joshieyu/DigitalAudioMixer/Documentation/Images/SSM2019TestOut.jpg

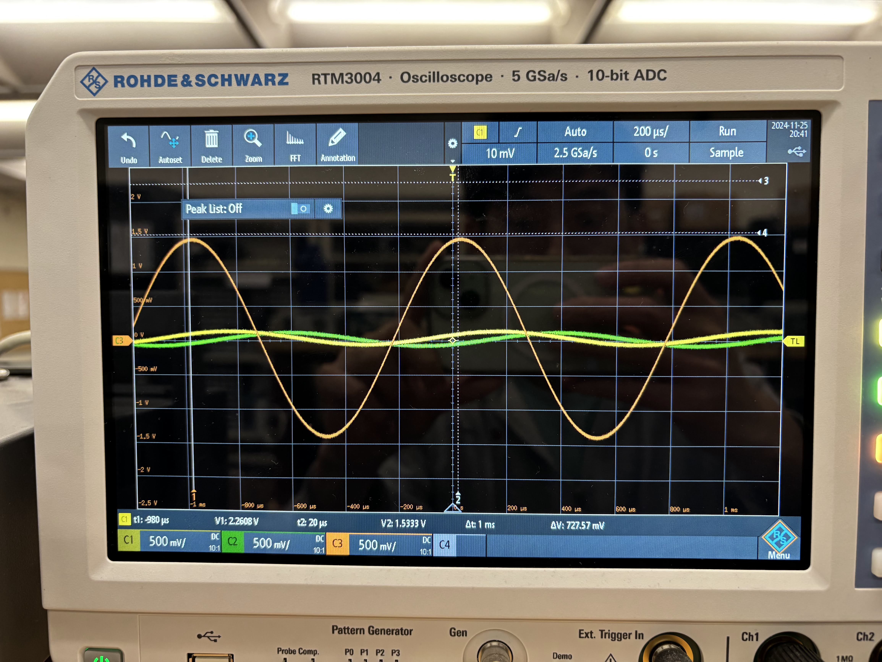
Documentation/Images/SSM2019TestOut.jpg
