joshieyu/DigitalAudioMixer/Documentation/Images/OPA2134TestOut.JPG

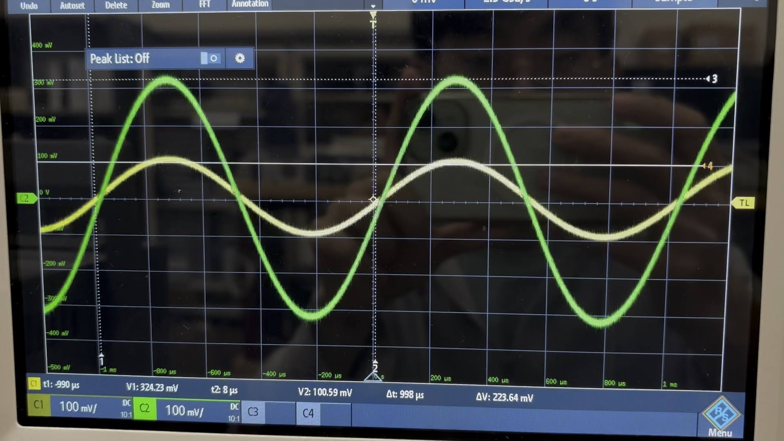
Documentation/Images/OPA2134TestOut.JPG
