joshieyu/DigitalAudioMixer/Resources/XK-AUDIO-316-MC-AB-Design-Files/XK-AUDIO-316-MC-AB-PCBA-1V1-A/README.txt

README.TXT
----------

Additional information relating to the build of PCB Assembly XK-AUDIO-316-MC-AB (xcore.ai MC audio board).

Design Ref    : XMS0004
Version       : 1V1
Build Variant : A

Date          : 17th August 2022

PCB Design tool : Altium Designer 21

Description of files included in XMS0004-PCBA-1V1-A.ZIP:

./README.TXT    This file.

./XK-AUDIO-316-MC-AB-ASSY-DWG-1V1-A.PDF    Assembly Drawing

./BOM/          This directory contains the bill of materials and component position files for assembly.

XK-AUDIO-316-MC-AB-XY-1V1-A.XLS    Component Position Data
XK-AUDIO-316-MC-AB-BOM-1V1-A.XLS   Bill Of Materials

./XK-AUDIO-316-MC-AB-PCB-1V1.zip       This is a zip file containing fabrication information for the PCB.
