joshieyu/DigitalAudioMixer/Documentation/Diagrams/biquad.jpg

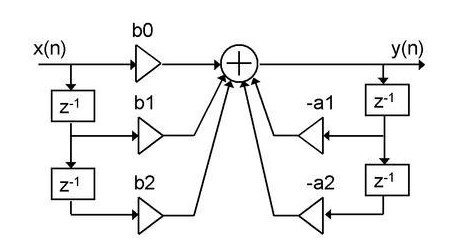
Documentation/Diagrams/biquad.jpg
