joshieyu/DigitalAudioMixer/Documentation/Diagrams/Hardware Flowchart (Chan Edition).png

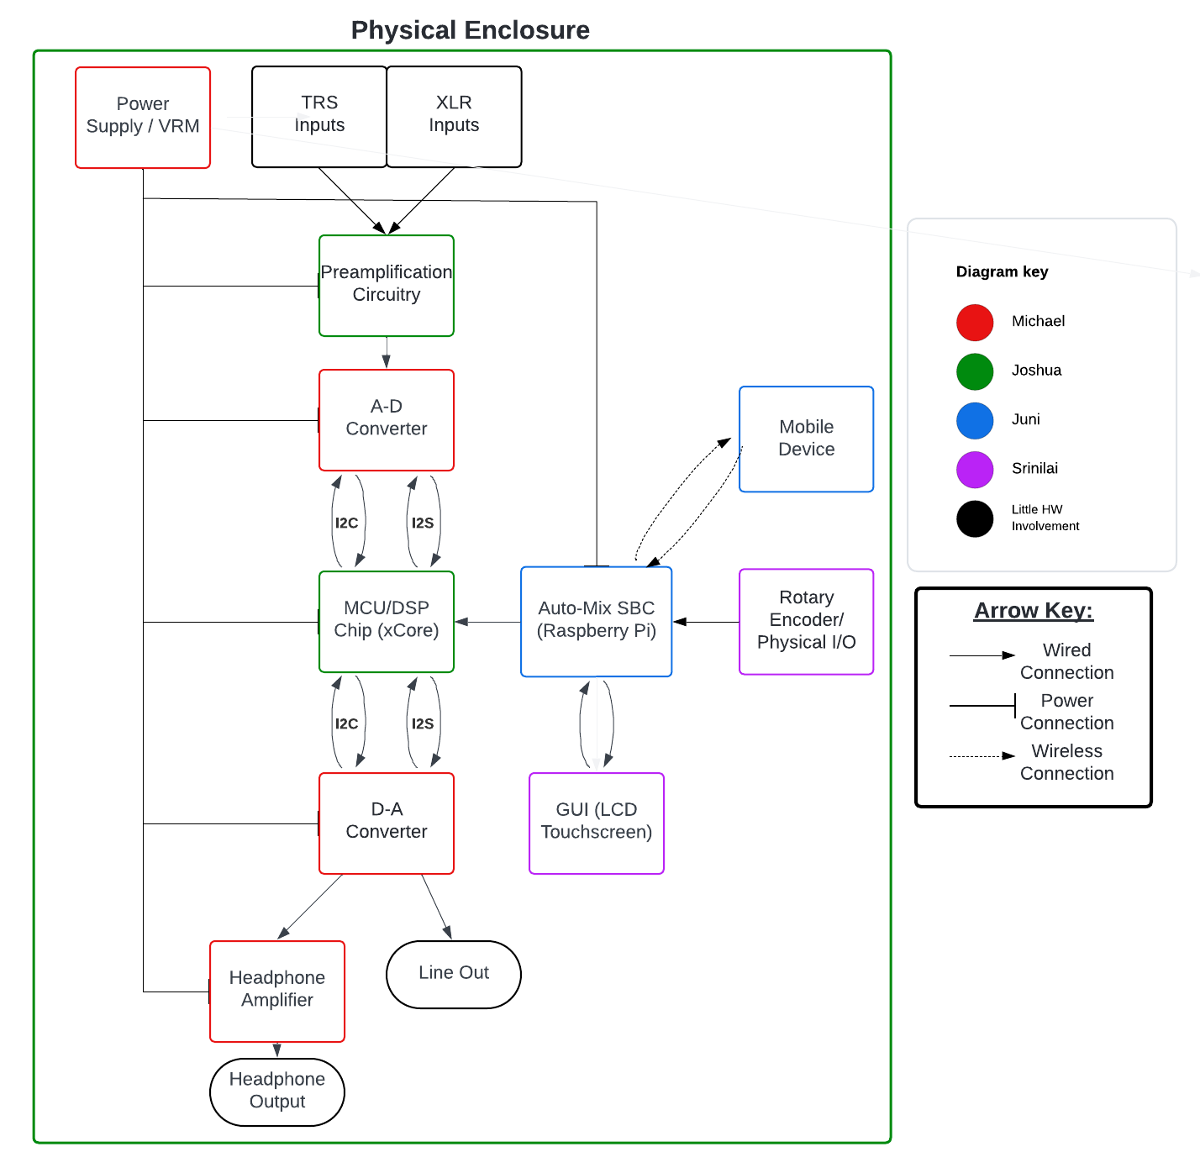
Documentation/Diagrams/Hardware Flowchart (Chan Edition).png
