joshieyu/DigitalAudioMixer/Documentation/imageRequests/biquadRequest.png

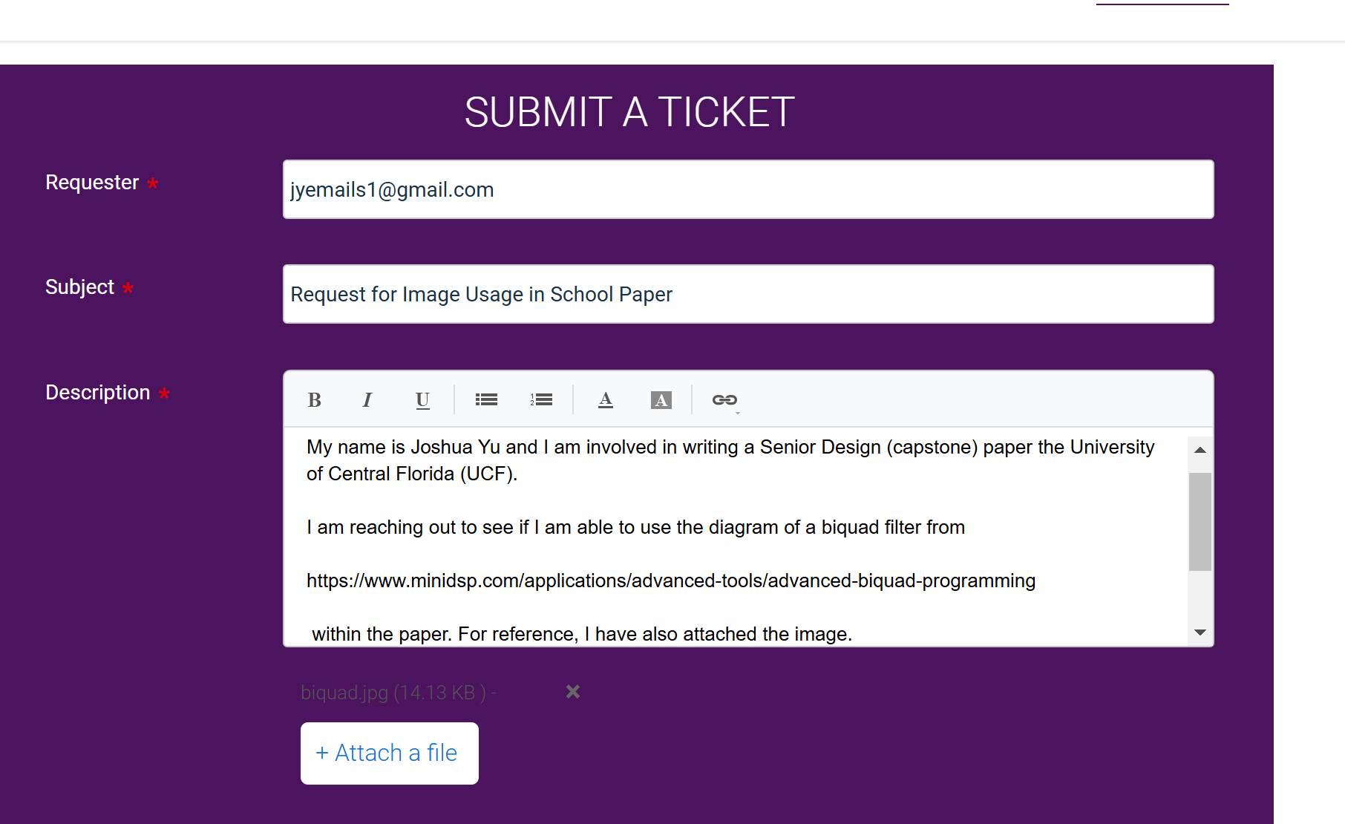
Documentation/imageRequests/biquadRequest.png
