joshieyu/DigitalAudioMixer/Documentation/imageRequests/biquadRequestApproval.png

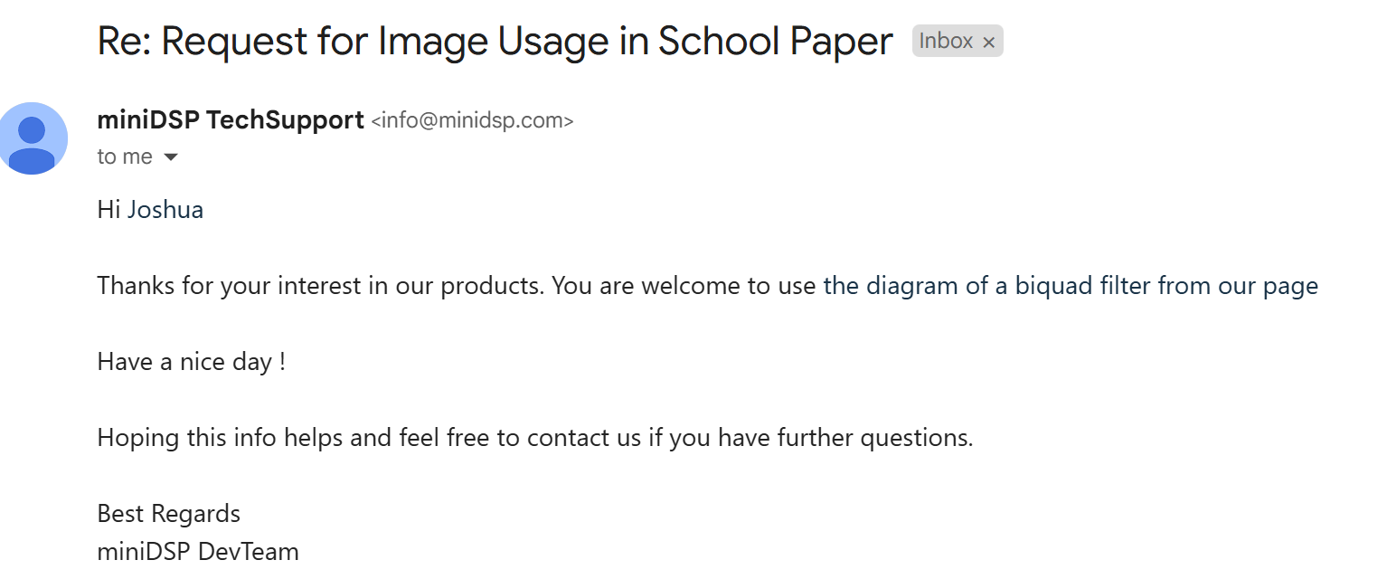
Documentation/imageRequests/biquadRequestApproval.png
