joshieyu/DigitalAudioMixer/Documentation/Images/BehringerFlow8.jpg

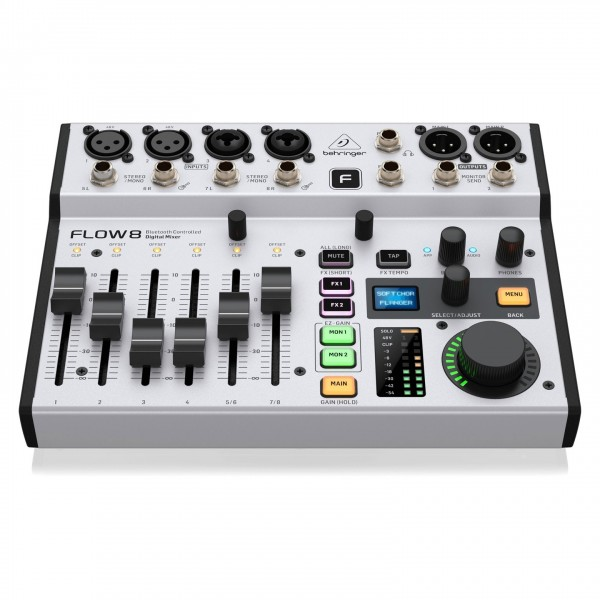
Documentation/Images/BehringerFlow8.jpg
