joshieyu/DigitalAudioMixer/Documentation/Images/MixerMockupCropped.png

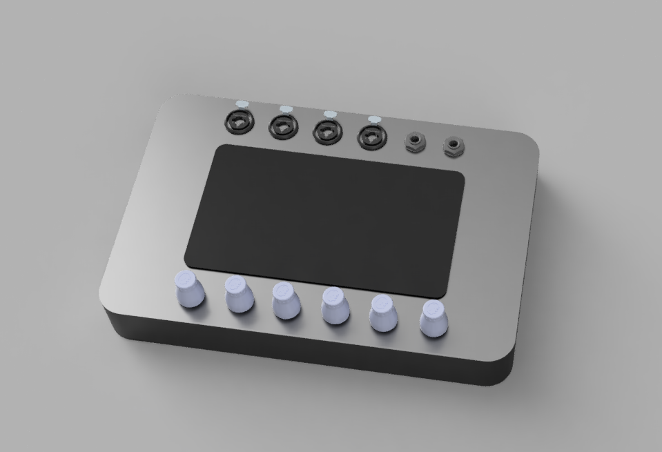
Documentation/Images/MixerMockupCropped.png
