joshieyu/DigitalAudioMixer/Documentation/Images/QSCTouchmix8.jpg

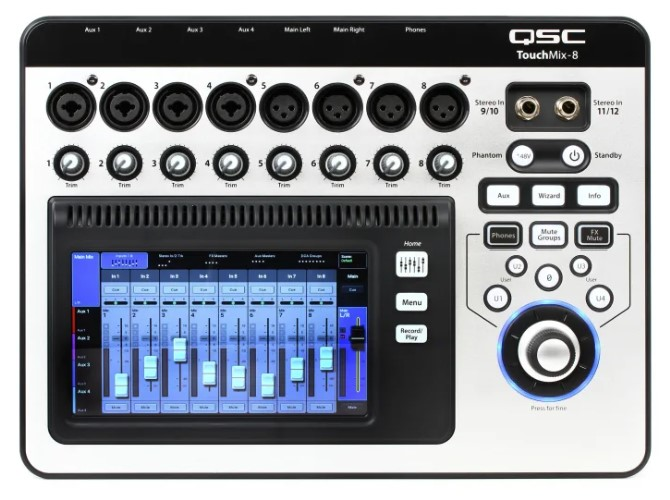
Documentation/Images/QSCTouchmix8.jpg
