joshieyu/DigitalAudioMixer/Documentation/Images/RaspberryPi5.jpg

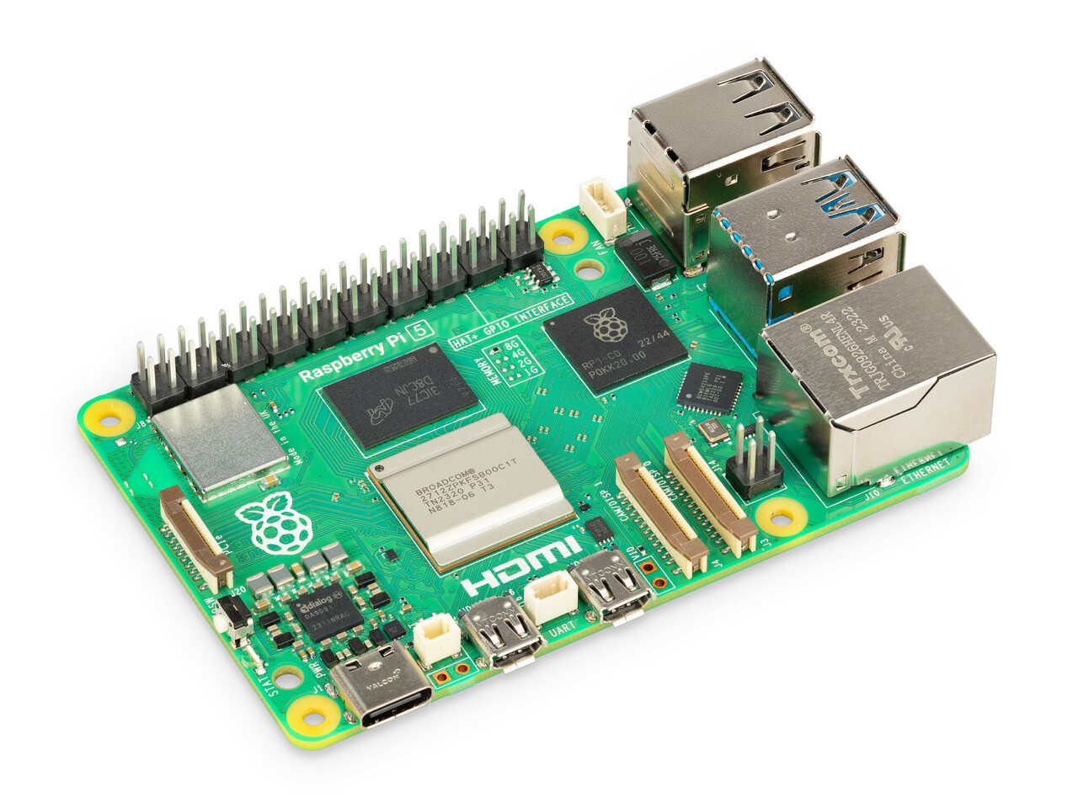
Documentation/Images/RaspberryPi5.jpg
