joshieyu/DigitalAudioMixer/Documentation/Images/SSM2019ChatGPT.png

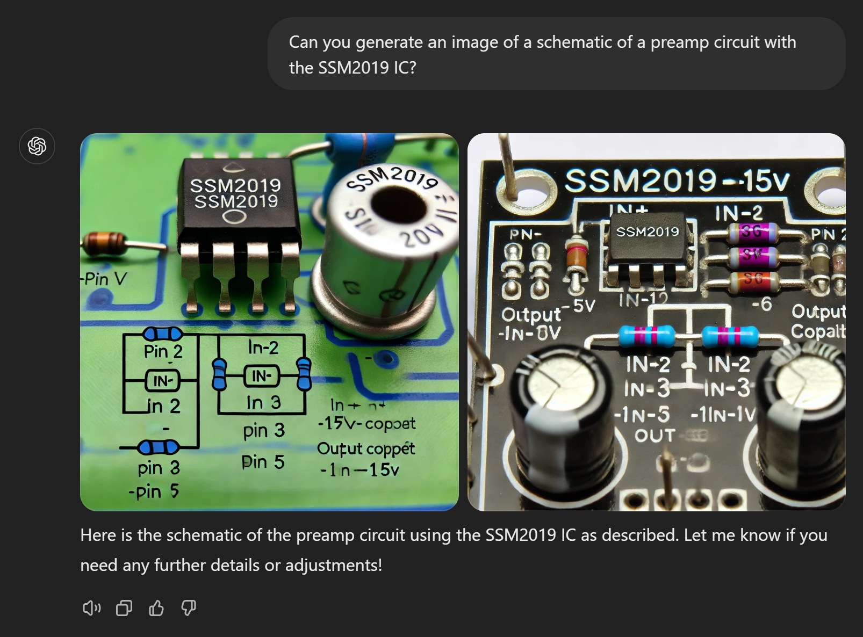
Documentation/Images/SSM2019ChatGPT.png
