joshieyu/DigitalAudioMixer/Documentation/Images/xcoreImage.jpg

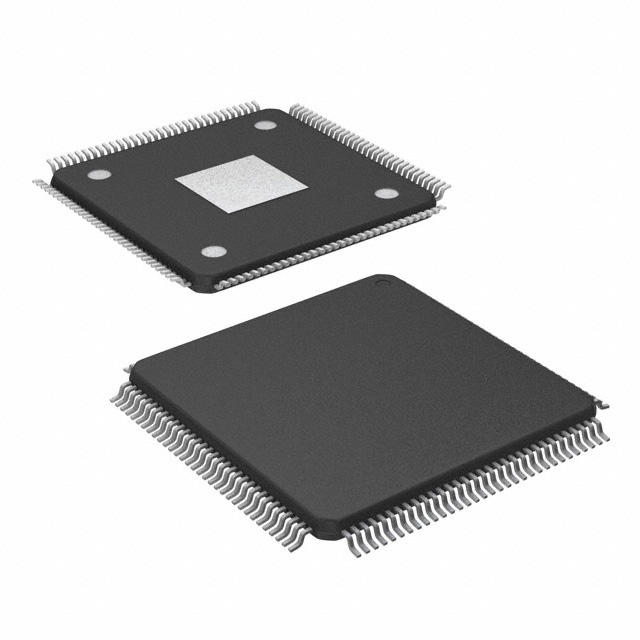
Documentation/Images/xcoreImage.jpg
