joshieyu/DigitalAudioMixer/Documentation/Schematics/InstPreampSchematic.png

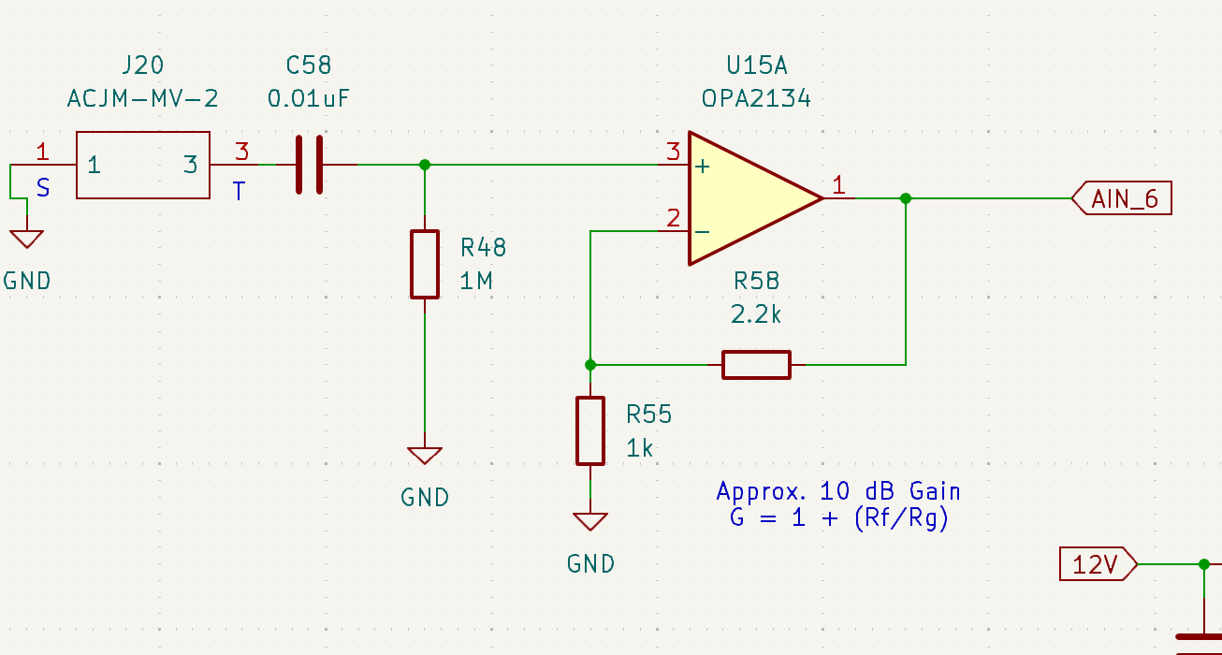
Documentation/Schematics/InstPreampSchematic.png
