joshieyu/DigitalAudioMixer/Documentation/Schematics/PreampSchematic.png

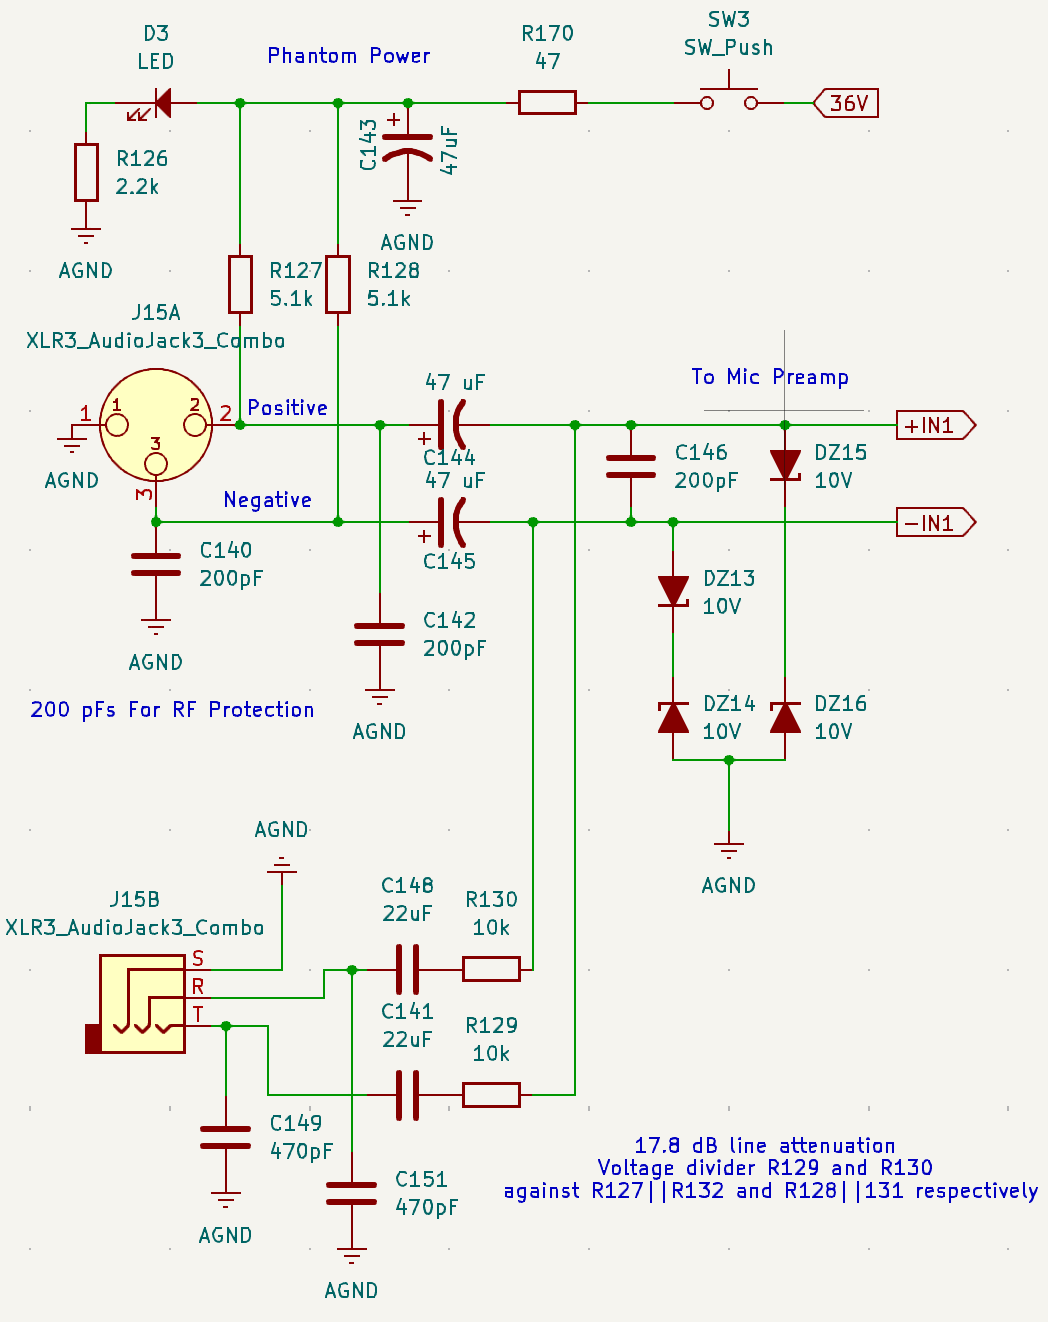
Documentation/Schematics/PreampSchematic.png
