joshieyu/DigitalAudioMixer/Documentation/Schematics/PreampSchematicFull.png

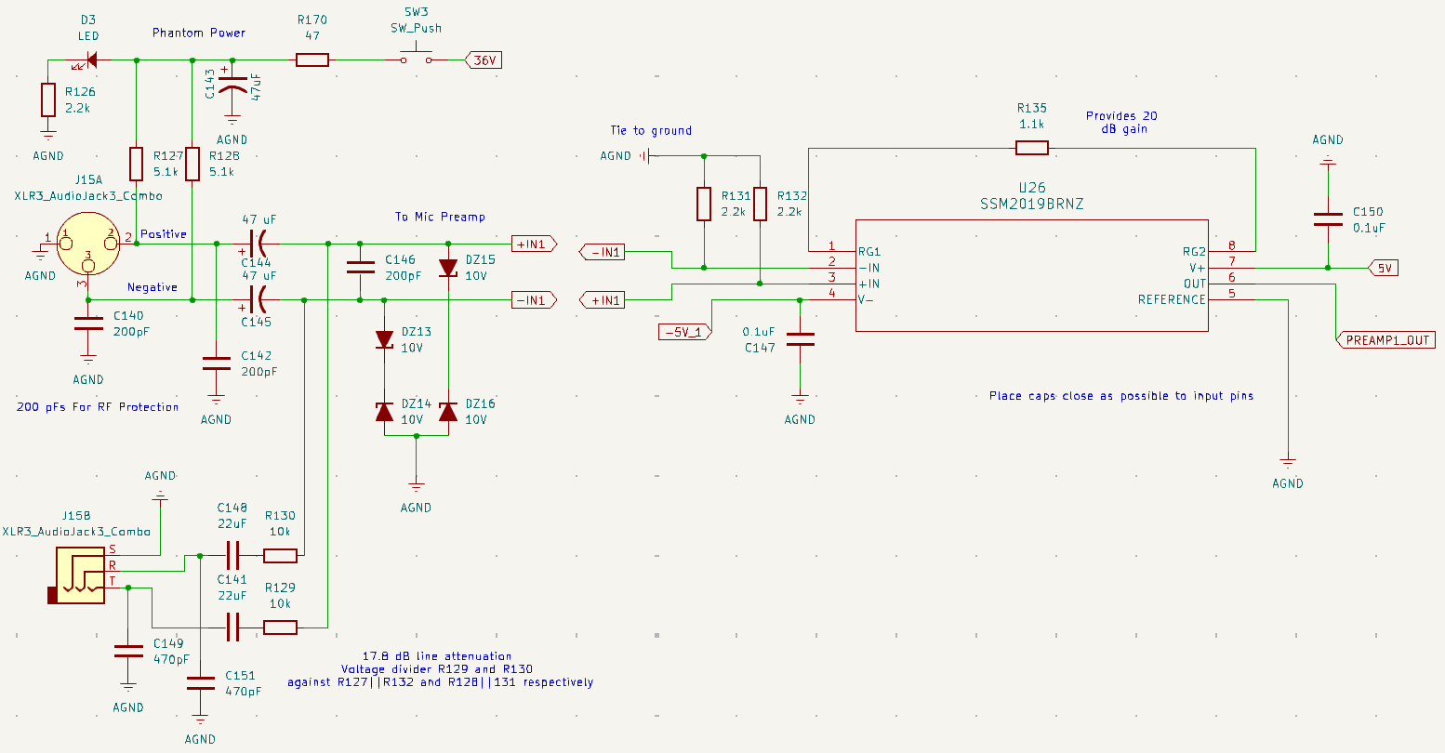
Documentation/Schematics/PreampSchematicFull.png
