joshieyu/DigitalAudioMixer/website/src/assets/crewmates/blue.png

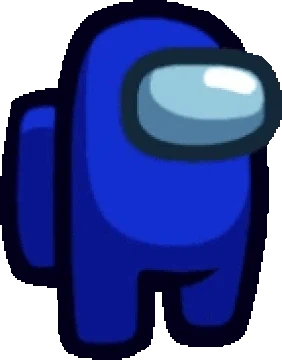
website/src/assets/crewmates/blue.png
