joshieyu/DigitalAudioMixer/website/src/assets/crewmates/yellow.png

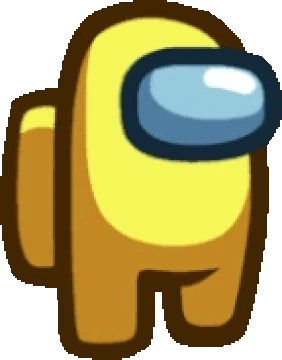
website/src/assets/crewmates/yellow.png
