joshieyu/DigitalAudioMixer/website/src/assets/roleReveal.png

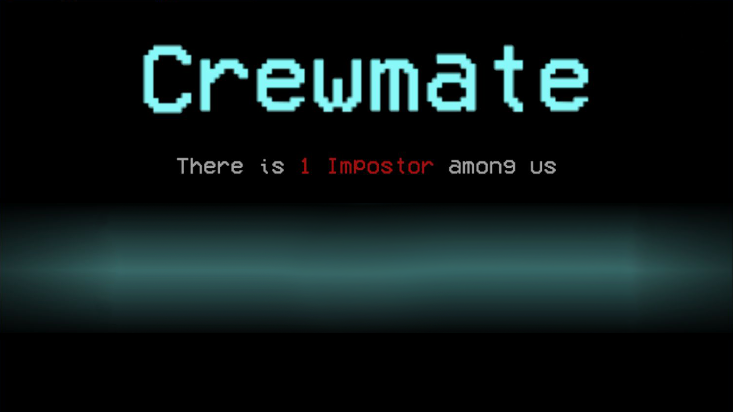
website/src/assets/roleReveal.png
