joshieyu/DigitalAudioMixer/Resources/XK-AUDIO-316-MC-AB-Design-Files/XK-AUDIO-316-MC-AB-PCBA-1V1-A/BOM/XK-AUDIO-316-MC-AB-BOM-1V1-A.xls

BILL OF MATERIALS
DESIGN | XMS0004
REVISION | 1V1
VARIANT | A
DATE | 17/08/2022 17:56:27
ITEM | DESCRIPTION | MANUFACTURER | PART NUMBER | QUANTITY | DESIGNATOR
1 | Pin Header, Male, Vertical, Through Hole, 2 Way, 1x2, 0.1 Inch Pitch | FCI | 68001-202HLF | 5 | J14, J17, J30, J39, J40
2 | USB Micro B Receptacle, Right Angle, SMD w/2 DIP Legs | FCI | 10118193-0001LF | 3 | J2, J16, J23
3 | TRS jack, 3.5mm, SMD | CUI | SJ-3523-SMT | 8 | J18, J19, J20, J21, J25, J26, J27, J28
4 | Pin Header, Male, Vertical, Through Hole, 3 Way, 1x3, 0.1 Inch Pitch | FCI | 68001-203HLF | 1 | J22
5 | Pin Header, Male, Vertical, Through Hole, 20 Way, 2x10, 0.1 Inch Pitch | FCI | 67997-220HLF | 1 | J7
6 | Optical Digital Audio Transmitter, Black Shutter, 16Mbps max, 2.7-5.5V, Through Hole | Aixin Opto-Electrical Technology | DLT1160A-B | 1 | J35
7 | Optical Digital Audio Receiver, Black Shutter, 16Mbps max, 2.7-5.5V, Through Hole | Aixin Opto-Electrical Technology | DLR1160-B | 1 | J36
8 | Standard DIN Connector, 5 Pin, 180 degrees, PCB Mount, Right Angle, Through Hole | CUI | SDS-50J | 2 | J31, J32
9 | RCA Jack, Right Angle, Orange, Through Hole | CUI | RCJ-017 | 2 | J33, J34
10 | Pin Header, Male, Vertical, Through Hole, 4 Way, 1x4, 0.1 Inch Pitch | FCI | 68001-204HLF | 8 | J3, J6, J8, J9, J10, J11, J12, J13
11 | BNC Jack, Board Mount, Vertical, 75 ohm, w/Mounting Posts | TE Connectivity | 5-1634503-3 | 1 | J29
12 | CHIP RESISTOR, 0.5 OHM, 100mW, 1%, 0603 | Yageo | RL0603FR-070R5L | 1 | R62
13 | CHIP RESISTOR, 0.1 OHM, 100mW, 1%, 0603 | Yageo | RL0603FR-070R1L | 1 | R73
14 | CHIP RESISTOR ARRAY, 4 ELEMENT, 36 OHM, 63mW, 5%, 0804 | Panasonic | EXB-28V360JX | 2 | R3, R14
15 | CHIP RESISTOR, 0.1 OHM, 250mW, 1%, 0805 | Yageo | RL0805FR-7W0R1L | 1 | R47
16 | CHIP CAPACITOR, CERAMIC, 2.2UF, 6.3V, 10%, X5R, 0402 | AVX | 04026D225KAT2A | 1 | C9
17 | CHIP CAPACITOR, CERAMIC, 10UF, 10V, 20%, X5R, 0603 | Murata | GRM188R61A106ME69 | 5 | C36, C38, C107, C111, C113
18 | CHIP CAPACITOR, CERAMIC, 22UF, 6.3V, 20%, X5R, 0603 | Murata | GRM188R60J226MEA0 | 1 | C117
19 | CHIP CAPACITOR, CERAMIC, 10UF, 10V, 20%, X7R, 0805 | Murata | GRM21BR71A106MA73L | 8 | C120, C121, C126, C127, C130, C131, C136, C137
20 | Ferrite Bead, 220R AT 100MHz, For Power Lines, AEC-Q200, 0603, 2.2A | Murata | BLM18KG221BH1 | 3 | FB1, FB5, FB6
21 | Ferrite Bead, 1000R AT 100MHz, For Signal Lines, 0402, 0.25A | Murata | BLM15HD102SN1 | 6 | FB2, FB3, FB7, FB8, FB9, FB10
22 | Power Inductor, 1.5uH, 2.6A, 65mR DCR, 2.5x2.0x1.2mm, SMD | Taiyo Yuden | MAMK2520H1R5M | 3 | L1, L2, L3
23 | Stereo Audio DAC, 32 bit/384kHz, 112dB SNR, PLL, 2Vrms Output, TSSOP28 | Texas Instruments | PCM5122PW | 4 | U10, U11, U12, U13
24 | Audio ADC, 4-Channel, 24 bit/192kHz, Single Ended or Differential, 110dB SNR, I2C/SPI Control, TSSOP30 | Texas Instruments | PCM1865DBTR | 2 | U19, U20
25 | Clock Generator, I2C Programmable, XTAL Input, 3 Outputs, MSOP10 | Silicon Labs | SI5351A-B-GT | 1 | U26
26 | Fractional-N Clock Multiplier, I2C/SPI Control, MSOP10 | Cirrus Logic | CS2100CP-CZZ | 1 | U22
27 | Processor, xcore.ai, 2400MIPS, 1.8V VDDIO, 60QFN | XMOS | XU316-1024-QF60A-C24 | 1 | U3
28 | Processor, xcore.ai, 2400MIPS, 128TQFP | XMOS | XU316-1024-TQ128-C24 | 1 | U8
29 | 2-channel I2C-bus multiplexer, TSSOP8 | NXP | PCA9540BDP,118 | 1 | U33
30 | Configurable Dual-Voltage Supply Translator, 4 bit, DQFN16 | Fairchild | FXL4TD245BQX | 2 | U2, U4
31 | Triple Logic Buffer, UHS Series, US8 | Fairchild | NC7NZ34K8X | 1 | U23
32 | Single Unbuffered Inverter, LVC Series, SOT23-5 | Nexperia | 74LVC1GU04GV | 1 | U30
33 | Single Buffer with 3-State Output, LVC Series, SON6 | Texas Instruments | SN74LVC1G125DRYR | 4 | U5, U21, U27, U32
34 | Two Input Non-Inverting Multiplexer, LVC Series, TSOP6 | Nexperia | 74LVC1G157GV | 2 | U24, U25
35 | Single D-Type Flip Flop with Reset, Positive Edge Trigger, LVC Series, SOT23-6 (SC-74) | Nexperia | 74LVC1G175GV | 2 | U29, U31
36 | Memory, Flash, SPI, Multi-IO, 8Mb (4Kx256), 1.65V to 1.95V, USON-8 (2x3mm) | Winbond | W25Q80EWUXIE | 1 | U1
37 | Memory, Flash, SPI, Multi-IO, 32Mb (16Kx256), 2.7 to 3.6V, QE = 1, SOIC-8-W | Winbond | W25Q32JVSSIQ | 1 | U9
38 | Optocoupler, Schmitt Trigger Output, 3-15V, 1.6mA Turn-On, PDIP6_SMD | ON Semiconductor | H11L1SM | 1 | U28
39 | Voltage Regulator, Dual, 3.3V/1.8V, 150mA, Low Iq, Low Dropout, X2SON-6 | Texas Instruments | TLV7163318PDPQR | 1 | U6
40 | DC-DC Synchronous Buck Converter, Adjustable, PFM/PWM, Power Good, 2.2MHz, 1A, SOT563 | Diodes Incorporated | AP61102Z6-7 | 3 | U7, U16, U17
41 | Voltage Regulator, Linear, Fixed, 1V8, 200mA, Low Iq=2uA, Output Active Discharge, TSOT23-5 | Toshiba | TCR2LF18,LM | 1 | U18
42 | USB Positive Overvoltage Protection Controller, Internal P-FET, OVLO 6.25V, TSOT23-5 | ON Semiconductor | NCP360SNAET1G | 1 | U14
43 | Voltage Regulator, Linear, Fixed, 3V3, 700mA, w/enable, SOT89-5 | Torex Semiconductor | XC6227C331PR-G | 1 | U15
44 | Precision Adjustable Current Limited Load Switch, 3.0 - 5.5V, 2.1A max, Active High Enable, SOT26 | Diodes Incorporated | AP22653W6-7 | 2 | U34, U35
45 | Crystal, 24MHz, Freq Tol. ±30ppm, Freq Stab. ±30ppm, CL 12pF, 3.2x2.5mm SMD | Seiko Epson | FA-238 24.0000MD30X-W | 1 | X2
46 | Crystal, 24MHz, Freq Tol. ±8ppm, Freq Stab. ±12ppm, CL 10pF, Max ESR 70 Ohm, 2.0x1.6mm SMD | Murata | XRCGB24M000FFS1CR0 | 1 | X1
47 | Crystal, 25MHz, Freq Tol. ±25ppm, Freq Stab. ±40ppm, CL 8pF, Max ESR 80 Ohm, 2.0x1.6mm SMD | Murata | XRCGB25M000FAM10R0 | 1 | X4
48 | Crystal, 24MHz, Freq Tol. ±30ppm, Freq Stab. ±30ppm, CL 18pF, Max ESR 40 Ohm, 5x3.2mm SMD | CTS | 445C33D24M00000 | 1 | X3
49 | Polymer ESD Protection Device, 24V Stand-Off, 0.25pF, 0603 | Tyco | PESD0603-240 | 2 | D11, D12
50 | ESD Protection Diode Array, 0.6pF, SC-70-6 (SC-88) | ON Semiconductor | NUP4114UCLW1T2G | 2 | D2, D8
51 | BJT Transistor, NPN, 40V, 200mA, SOT23 | Nexperia | MMBT3904,215 | 1 | Q1
52 | Zener Diode, 3.9V, 2%, 0.2W, SOD-323F | ON Semiconductor | MM3Z3V9B | 1 | D13
53 | Diode, 100V, 0.2A, SOD123 | ON Semiconductor | MMSD914T1G | 2 | D9, D10
54 | LED, GREEN, 0603 | Kingbright | APT1608CGCK | 4 | D4, D5, D6, D7
55 | LED, Top View, RED/GREEN, SMD, 0606 | Lite-On | LTST-C195KGJRKT | 2 | D1, D3
56 | Tactile Switch, Momentary, J Bend SMD | C&K | KSC421J 70SH LFS | 3 | SW1, SW2, SW3
57 | PTC Fuse, SMD, 0.35A hold, 0.75A trip, 6V, 0805 | Bel Fuse | 0ZCK0035FF2G | 1 | F1
58 | Snap-in PCB Spacer Support, 6mm | KANG YANG (Toby Electronics) | DCB-6 | 8 | PROD12, PROD13, PROD14, PROD15, PROD16, PROD17, PROD18, PROD19
59 | Jumper Shunt, Single Circuit, Open Type, 2.54mm Pitch, 6mm High, Gold Flash | Sullins | QPC02SXGN-RC | 12 | PROD1, PROD2, PROD3, PROD4, PROD5, PROD6, PROD7, PROD8, PROD9, PROD10, PROD11, PROD24
60 | Machine screw, M2 thread, 6mm length, Steel, BZP, Pan head Pozidriv | TR Fastenings | M2 6 PRSTMC Z100 | 4 | PROD20, PROD21, PROD22, PROD23
61 | CHIP RESISTOR, 680 OHM, 63mW, 1%, 0402 | Yageo | RC0402FR-07680RL | 1 | R21
62 | CHIP RESISTOR, 4.7K OHM, 63mW, 1%, 0402 | Yageo | RC0402FR-074K7L | 6 | R2, R7, R8, R9, R10, R22
63 | CHIP RESISTOR, 10K OHM, 63mW, 1%, 0402 | Yageo | RC0402FR-0710KL | 6 | R4, R5, R11, R16, R17, R29
64 | CHIP RESISTOR, 20K OHM, 63mW, 1%, 0402 | Yageo | RC0402FR-0720KL | 1 | R30
65 | CHIP RESISTOR, 47K OHM, 63mW, 1%, 0402 | Yageo | RC0402FR-0747KL | 1 | R28
66 | CHIP RESISTOR, 150K OHM, 63mW, 1%, 0402 | Yageo | RC0402FR-07150KL | 1 | R31
67 | CHIP RESISTOR, 1.0M OHM, 63mW, 5%, 0402 | Yageo | RC0402JR-071ML | 1 | R19
68 | CHIP RESISTOR, ZERO OHM JUMPER, 1A, 0603 | Yageo | RC0603JR-070RL | 14 | R53, R54, R60, R61, R68, R83, R89, R105, R116, R118, R120, R123, R139, R140
69 | CHIP RESISTOR, 33 OHM, 0.1W, 1%, 0603 | Yageo | RC0603FR-0733RL | 23 | R12, R13, R24, R25, R27, R32, R39, R40, R80, R86, R90, R93, R94, R95, R96, R97, R98, R99, R115, R117, R122, R125, R126
70 | CHIP RESISTOR, 68 OHM, 0.1W, 1%, 0603 | Yageo | RC0603FR-0768RL | 1 | R108
71 | CHIP RESISTOR, 100 OHM, 0.1W, 1%, 0603 | Yageo | RC0603FR-07100RL | 1 | R111
72 | CHIP RESISTOR, 220 OHM, 0.1W, 1%, 0603 | Yageo | RC0603FR-07220RL | 4 | R109, R110, R113, R114
73 | CHIP RESISTOR, 470 OHM, 0.1W, 1%, 0603 | Yageo | RC0603FR-07470RL | 13 | R33, R34, R35, R36, R49, R50, R51, R52, R55, R56, R57, R58, R102
74 | CHIP RESISTOR, 680 OHM, 0.1W, 1%, 0603 | Yageo | RC0603FR-07680RL | 1 | R20
75 | CHIP RESISTOR, 1.0K OHM, 0.1W, 1%, 0603 | Yageo | RC0603FR-071KL | 1 | R91
76 | CHIP RESISTOR, 4.7K OHM, 0.1W, 1%, 0603 | Yageo | RC0603FR-074K7L | 7 | R41, R42, R63, R127, R128, R129, R130
77 | CHIP RESISTOR, 10K OHM, 0.1W, 1%, 0603 | Yageo | RC0603FR-0710KL | 16 | R15, R23, R37, R38, R43, R59, R69, R72, R74, R106, R119, R121, R135, R136, R138, R142
78 | CHIP RESISTOR, 15K OHM, 0.1W, 1%, 0603 | Yageo | RC0603FR-0715KL | 1 | R70
79 | CHIP RESISTOR, 20K OHM, 0.1W, 1%, 0603 | Yageo | RC0603FR-0720KL | 2 | R66, R76
80 | CHIP RESISTOR, 47K OHM, 0.1W, 1%, 0603 | Yageo | RC0603FR-0747KL | 9 | R44, R78, R79, R81, R82, R84, R85, R87, R88
81 | CHIP RESISTOR, 68K OHM, 0.1W, 1%, 0603 | Yageo | RC0603FR-0768KL | 3 | R67, R71, R143
82 | CHIP RESISTOR, 100K OHM, 0.1W, 1%, 0603 | Yageo | RC0603FR-07100KL | 4 | R45, R46, R64, R107
83 | CHIP RESISTOR, 220K OHM, 0.1W, 1%, 0603 | Yageo | RC0603FR-07220KL | 1 | R77
84 | CHIP RESISTOR, 240K OHM, 0.1W, 1%, 0603 | Yageo | RC0603FR-07240KL | 1 | R75
85 | CHIP RESISTOR, 470K OHM, 0.1W, 1%, 0603 | Yageo | RC0603FR-07470KL | 1 | R48
86 | CHIP RESISTOR, 1.0M OHM, 0.1W, 5%, 0603 | Yageo | RC0603JR-071ML | 1 | R18
87 | CHIP RESISTOR, 10 OHM, 0.25W, 1%, 1206 | Yageo | RC1206FR-0710RL | 1 | R104
88 | CHIP RESISTOR, 68 OHM, 0.25W, 1%, 1206 | Yageo | RC1206FR-0768RL | 2 | R100, R101
89 | CHIP RESISTOR, 75 OHM, 0.25W, 1%, 1206 | Yageo | RC1206FR-0775RL | 2 | R92, R112
90 | CHIP RESISTOR, 220 OHM, 0.25W, 1%, 1206 | Yageo | RC1206FR-07220RL | 1 | R103
91 | CHIP CAPACITOR, CERAMIC, 18PF, 50V, 5%, NP0, 0402 | Yageo | CC0402JRNPO9BN180 | 4 | C11, C12, C60, C61
92 | CHIP CAPACITOR, CERAMIC, 27PF, 50V, 5%, NP0, 0402 | Yageo | CC0402JRNPO9BN270 | 2 | C144, C145
93 | CHIP CAPACITOR, CERAMIC, 33PF, 50V, 5%, NP0, 0402 | Yageo | CC0402JRNPO9BN330 | 1 | C156
94 | CHIP CAPACITOR, CERAMIC, 100PF, 50V, 10%, X7R, 0402 | Yageo | CC0402KRX7R9BB101 | 1 | C110
95 | CHIP CAPACITOR, CERAMIC, 470PF, 50V, 10%, X7R, 0402 | Yageo | CC0402KRX7R9BB471 | 1 | C37
96 | CHIP CAPACITOR, CERAMIC, 10NF, 50V, 10%, X7R, 0402 | Yageo | CC0402KRX7R9BB103 | 5 | C63, C108, C155, C174, C177
97 | CHIP CAPACITOR, CERAMIC, 100NF, 16V, 10%, X7R, 0402 | Yageo | CC0402KRX7R7BB104 | 103 | C1, C2, C3, C4, C7, C8, C10, C16, C17, C18, C19, C20, C21, C22, C23, C24, C25, C26, C27, C28, C29, C30, C31, C32, C33, C34, C35, C39, C40, C41, C42, C43, C44, C45, C46, C47, C48, C49, C50, C51, C52, C53, C54, C55, C56, C57, C58, C59, C62, C64, C72, C73, C75, C76, C78, C79, C81, C82, C90, C91, C93, C94, C96, C97, C99, C100, C103, C104, C106, C114, C123, C125, C133, C135, C140, C141, C142, C143, C146, C147, C148, C149, C151, C153, C154, C157, C158, C159, C160, C161, C162, C163, C164, C165, C166, C167, C168, C169, C170, C171, C172, C173, C175
98 | CHIP CAPACITOR, CERAMIC, 2.2NF, 50V, 5%, NP0, 0603 | Murata | GRM1885C1H222JA01D | 8 | C65, C66, C67, C68, C83, C84, C85, C86
99 | CHIP CAPACITOR, CERAMIC, 100NF, 50V, 10%, X7R, 0603 | Yageo | CC0603KRX7R9BB104 | 2 | C150, C152
100 | CHIP CAPACITOR, CERAMIC, 1.0UF, 16V, 10%, X5R, 0402 | Murata | GRM155R61C105MA12D | 11 | C5, C6, C13, C14, C15, C101, C102, C112, C118, C119, C176
101 | CHIP CAPACITOR, CERAMIC, 560PF, 50V, 5%, NP0, 0402 | Yageo | CC0402JRNPO9BN561 | 1 | C116
102 | CHIP CAPACITOR, CERAMIC, 4.7UF, 16V, 10%, X5R, 0603 | Murata | GRM188R61C475KE11D | 12 | C74, C80, C92, C98, C105, C109, C115, C122, C124, C132, C134, C178
103 | CHIP CAPACITOR, CERAMIC, 2.2UF, 16V, 10%, X5R, 0603 | Yageo | CC0603KRX5R7BB225 | 12 | C69, C70, C71, C77, C87, C88, C89, C95, C128, C129, C138, C139
104 | CHIP RESISTOR ARRAY, 4 ELEMENT, 470 OHM, 63mW, 5%, 0804 | Yageo | YC124-JR-07470RL | 1 | R1
105 | CHIP RESISTOR ARRAY, 4 ELEMENT, 47K OHM, 63mW, 5%, 0804 | Yageo | YC124-JR-0747KL | 1 | R6
NA | NO FIT COMPONENTS | NA | NA | 0 | J15, J24, J38, J1, J37, J41, J42, J43, J44, J4, J45, FB4, F2, R26, R65, R124, R131, R132, R133, R134, R141, R137
