joshieyu/DigitalAudioMixer/CAD/Parts/jack-1-4-1.snapshot.3/Jack1_4/Jack1_4.jpg

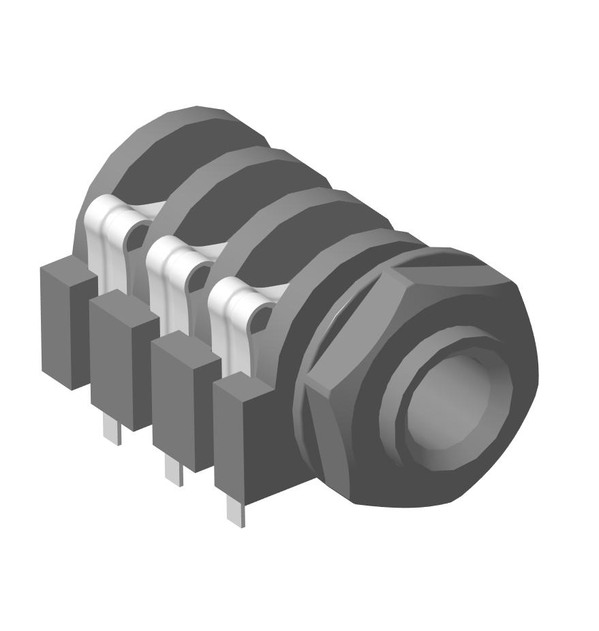
CAD/Parts/jack-1-4-1.snapshot.3/Jack1_4/Jack1_4.jpg
