joshieyu/DigitalAudioMixer/CAD/Parts/ky-040-knob-1.snapshot.2/ky040 knob.47.jpg

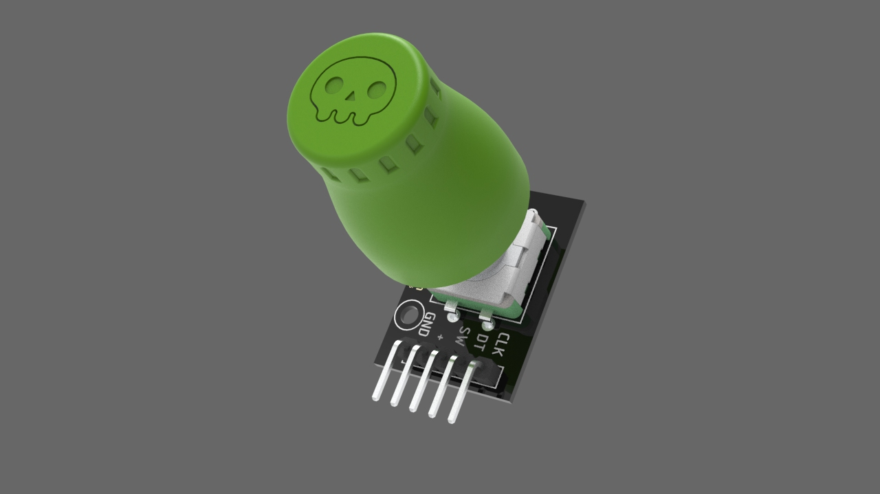
CAD/Parts/ky-040-knob-1.snapshot.2/ky040 knob.47.jpg
