joshieyu/DigitalAudioMixer/CAD/Parts/schurter-4304-6071-1.snapshot.6/Schurter - 4304.6071 Top.jpg

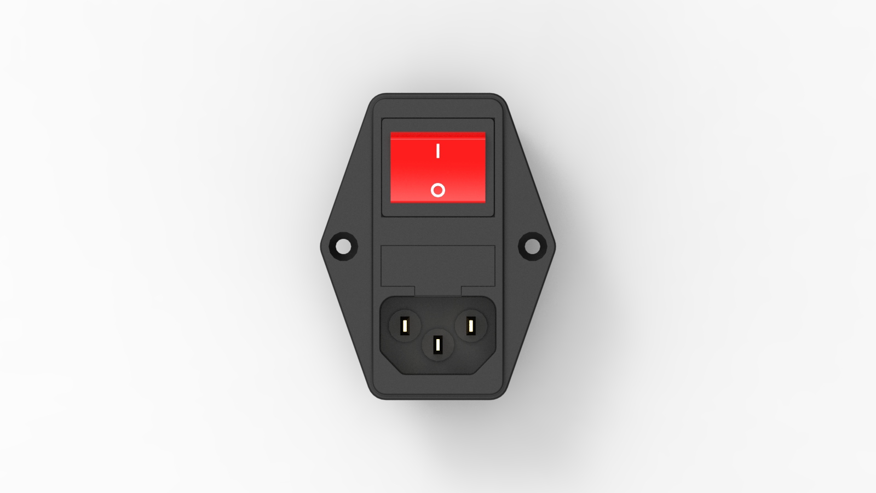
CAD/Parts/schurter-4304-6071-1.snapshot.6/Schurter - 4304.6071 Top.jpg
