joshieyu/DigitalAudioMixer/CAD/Parts/trs-jack-pj-313-1.snapshot.1/TRS Jack PJ-313(1).JPG

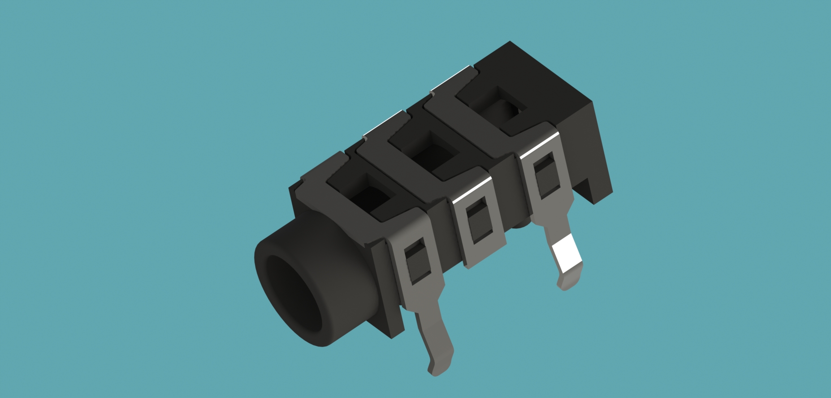
CAD/Parts/trs-jack-pj-313-1.snapshot.1/TRS Jack PJ-313(1).JPG
