joshieyu/DigitalAudioMixer/CAD/Parts/trs-jack-pj-313-1.snapshot.1/TRS Jack PJ-313/TRS Jack PJ-313.SLDASM

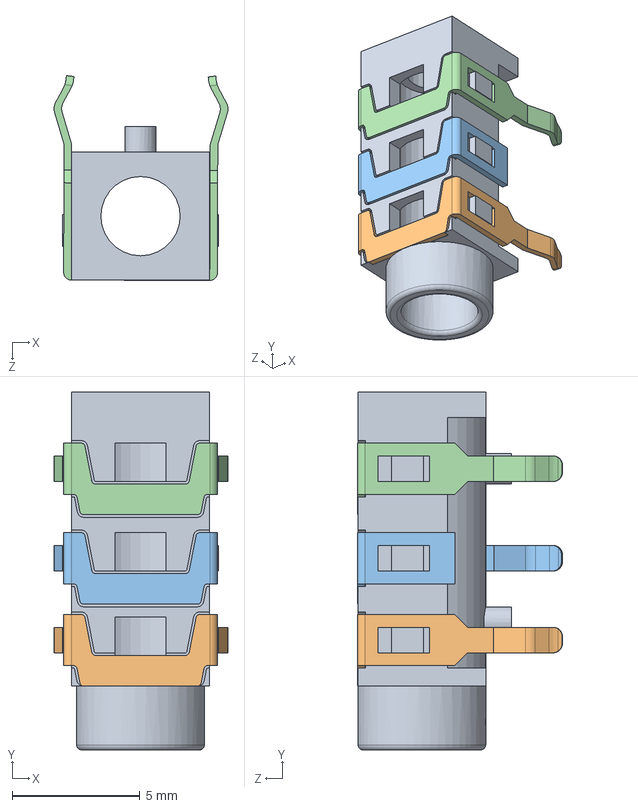
[picture p41: CAD file, 2024-07-25]
CAD/Parts/trs-jack-pj-313-1.snapshot.1/TRS Jack PJ-313/TRS Jack PJ-313.SLDASM
6.80 x 14.0 x 8.02 mm
