joshieyu/DigitalAudioMixer/CAD/Parts/rotary-encoder-1.snapshot.8/rotary encoder step files/Step Files/Rotary Encoder without pcb Assembly.stp

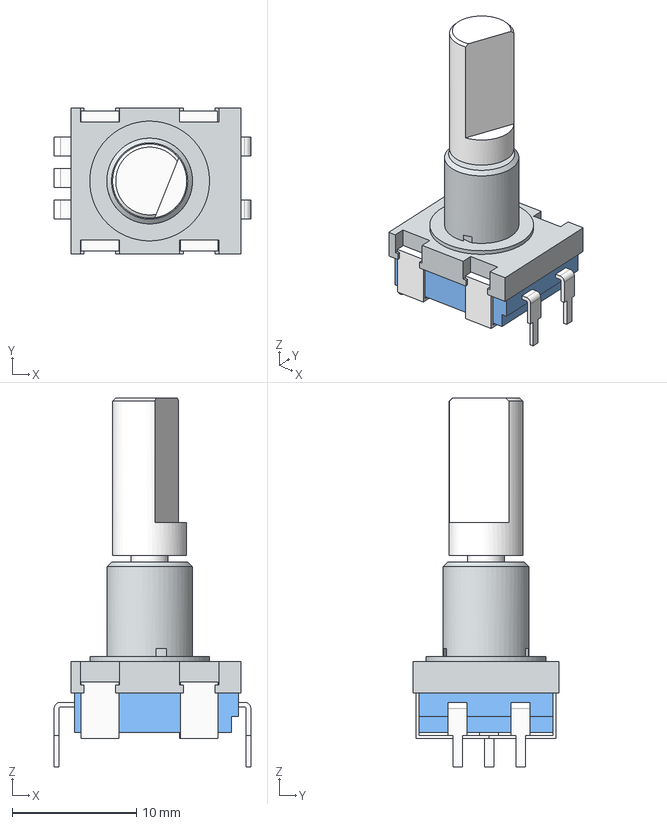
[picture p42: CAD file, 2024-07-25]
CAD/Parts/rotary-encoder-1.snapshot.8/rotary encoder step files/Step Files/Rotary Encoder without pcb Assembly.stp
15.8 x 11.8 x 29.7 mm
mtg flange
body_encoder
pins_encoder body_2 x 5
shaft_encoder
