joshieyu/DigitalAudioMixer/CAD/Parts/jack-1-4-1.snapshot.3/Jack1_4/Jack1_4.stp

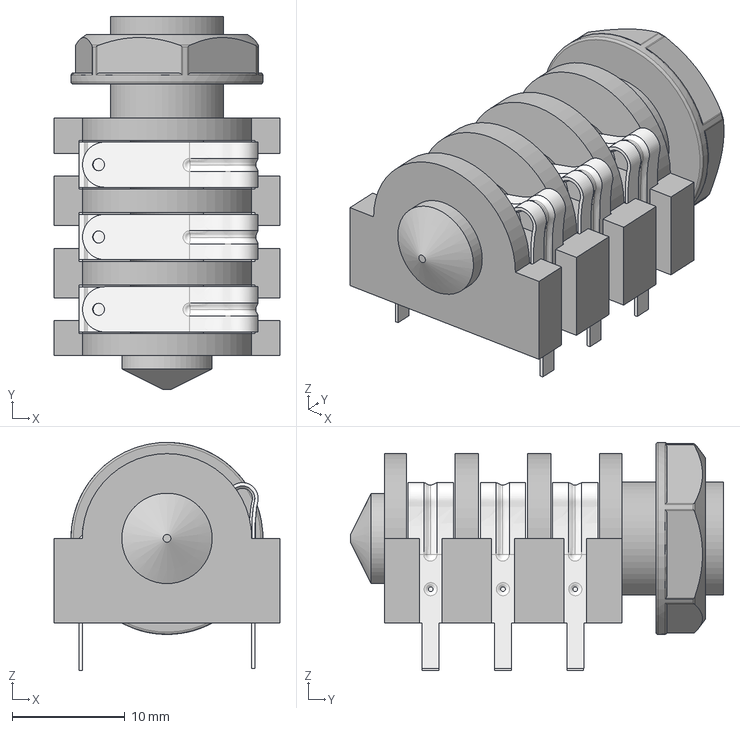
[picture p43: CAD file, 2024-07-25]
CAD/Parts/jack-1-4-1.snapshot.3/Jack1_4/Jack1_4.stp
20.0 x 33.0 x 20.2 mm
