joshieyu/DigitalAudioMixer/CAD/Parts/ky-040-knob-1.snapshot.2/KY-040 Knob v2.STEP

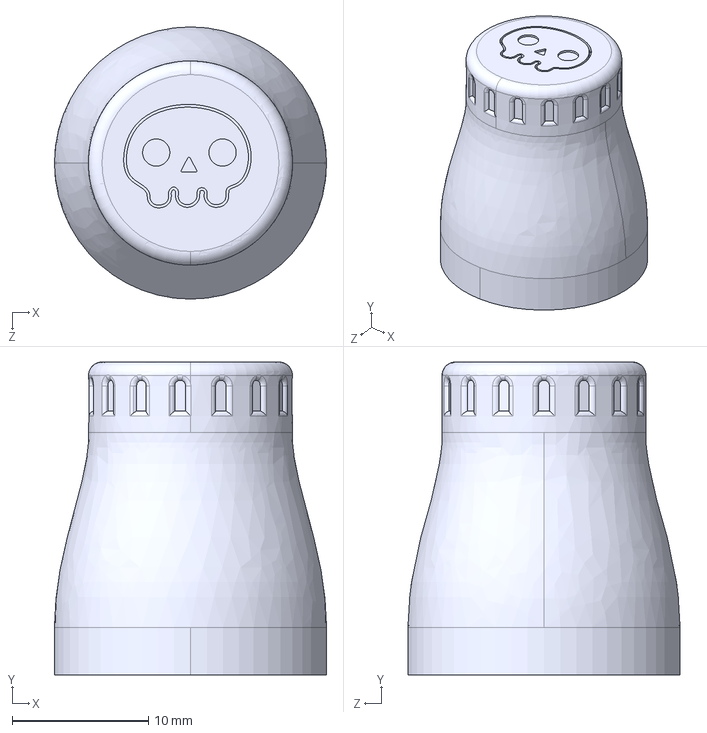
[picture p44: CAD file, 2024-07-25]
CAD/Parts/ky-040-knob-1.snapshot.2/KY-040 Knob v2.STEP
20.0 x 23.0 x 20.0 mm
