joshieyu/DigitalAudioMixer/CAD/Parts/neutrik-ncj6fi-v-1.snapshot.1/NCJ6FI-V.igs

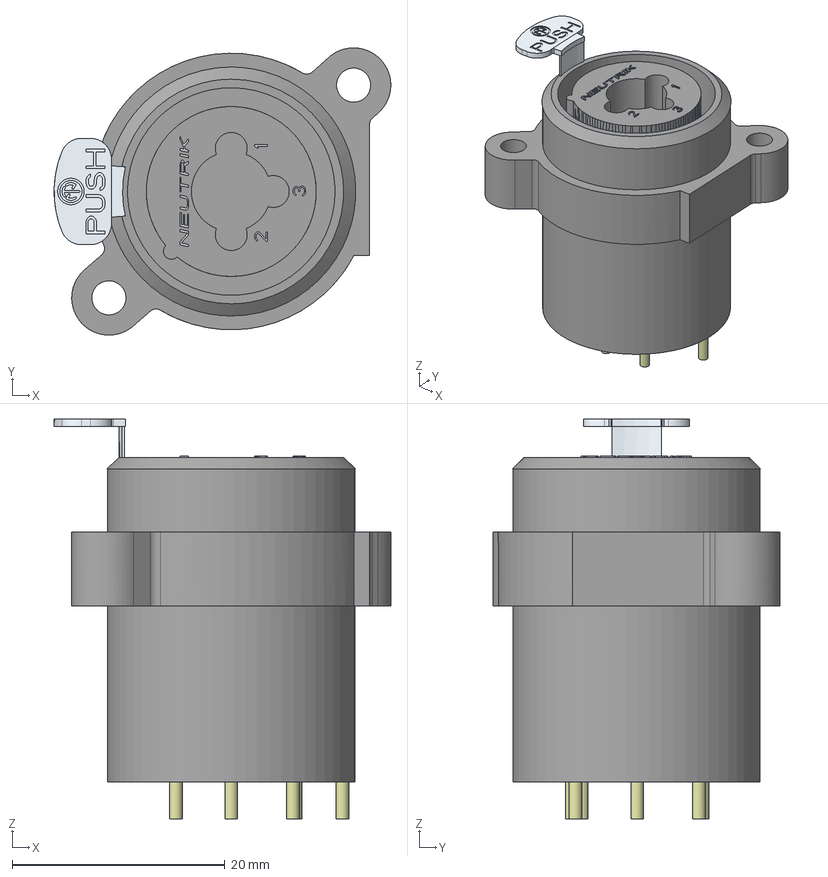
[picture p45: CAD file, 2024-07-25]
CAD/Parts/neutrik-ncj6fi-v-1.snapshot.1/NCJ6FI-V.igs
31.6 x 27.0 x 37.6 mm
