joshieyu/DigitalAudioMixer/CAD/Parts/rotary-encoder-1.snapshot.8/rotary encoder step files/Step Files/body_encoder.stp

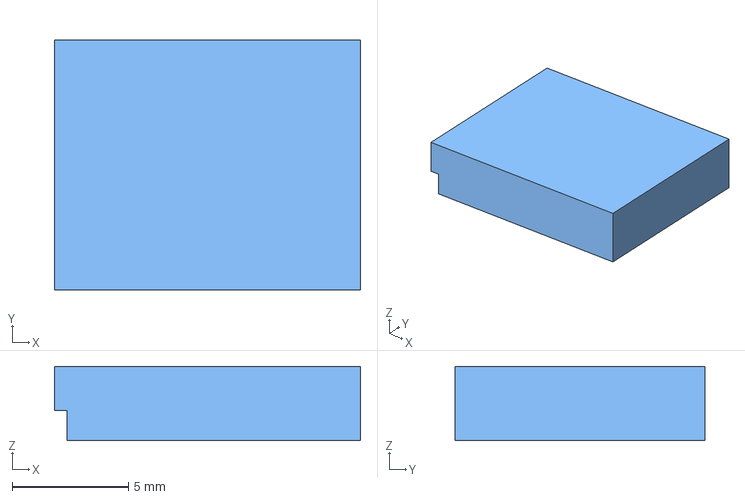
[picture p46: CAD file, 2024-07-25]
CAD/Parts/rotary-encoder-1.snapshot.8/rotary encoder step files/Step Files/body_encoder.stp
13.2 x 10.8 x 3.20 mm
