joshieyu/DigitalAudioMixer/CAD/Parts/schurter-4304-6071-1.snapshot.6/Schurter - 4304.6071 Power Entry Connector Receptacle wth Fuse.stp

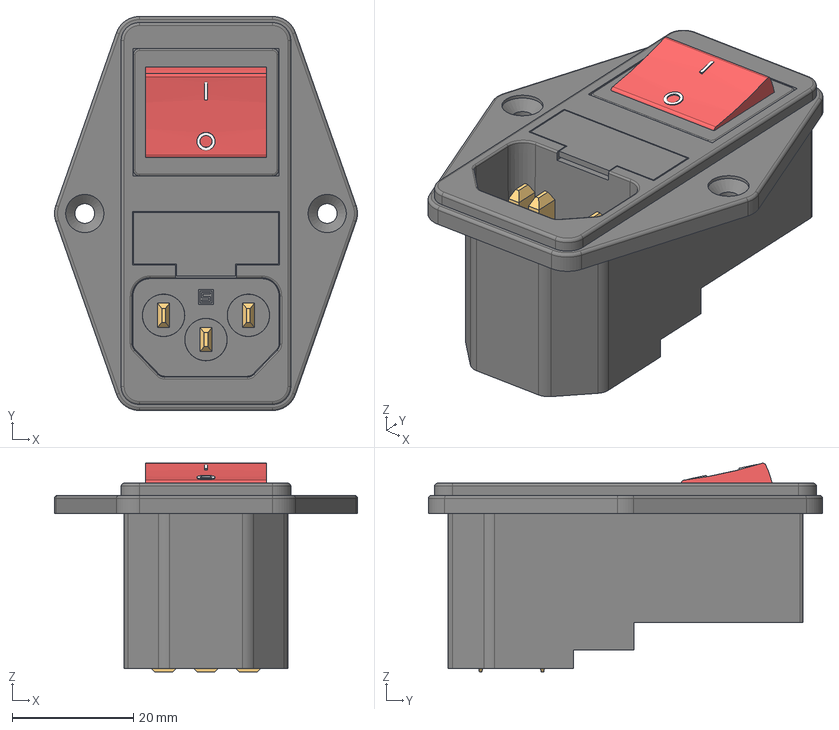
[picture p47: CAD file, 2024-07-25]
CAD/Parts/schurter-4304-6071-1.snapshot.6/Schurter - 4304.6071 Power Entry Connector Receptacle wth Fuse.stp
50.0 x 65.0 x 34.4 mm
