joshieyu/DigitalAudioMixer/Parts/BLM18AG601SZ1D/BLM18AG601SZ1D.step

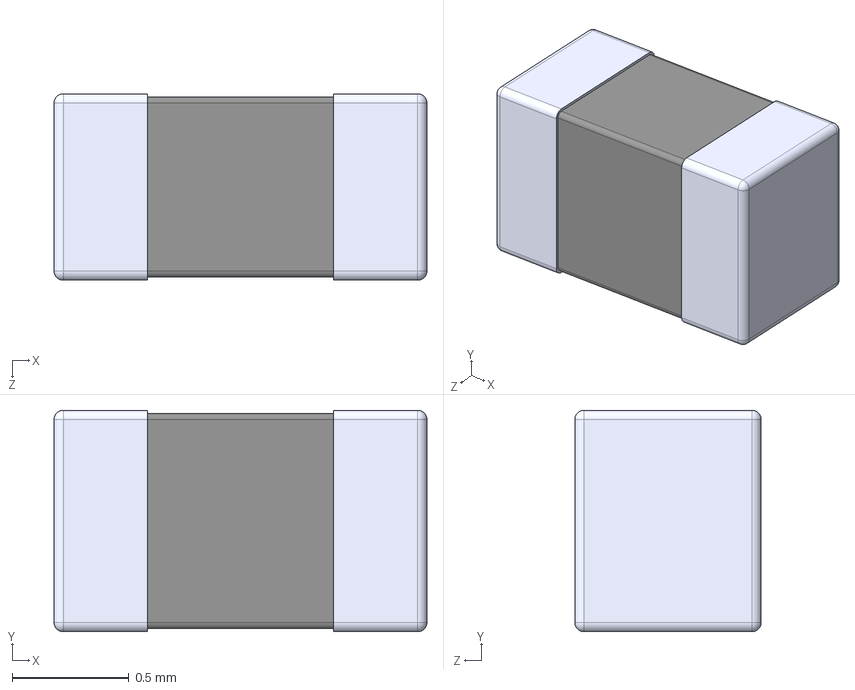
[picture p48: CAD file, 2024-11-12]
Parts/BLM18AG601SZ1D/BLM18AG601SZ1D.step
1.60 x 0.95 x 0.8 mm
