joshieyu/DigitalAudioMixer/Parts/FA_238_24_0000MB_C0/FA-238_EPS.step

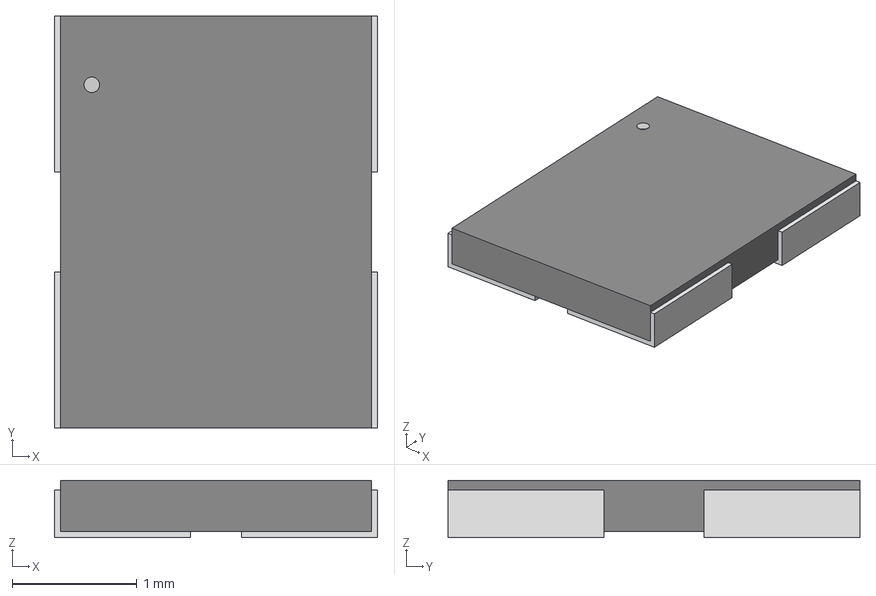
[picture p49: CAD file, 2024-09-13]
Parts/FA_238_24_0000MB_C0/FA-238_EPS.step
2.59 x 3.30 x 0.46 mm
