joshieyu/DigitalAudioMixer/Parts/FTSH_110_01_F_DV_K/CON20_2X10_DUK_FTSH_SAI.step

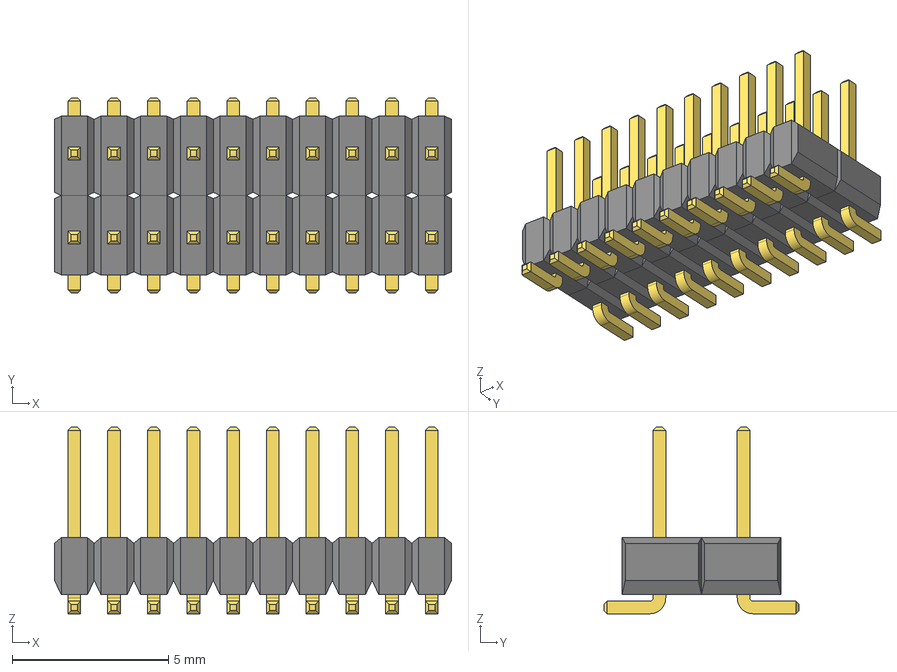
[picture p50: CAD file, 2024-11-01]
Parts/FTSH_110_01_F_DV_K/CON20_2X10_DUK_FTSH_SAI.step
12.7 x 6.25 x 5.97 mm
