joshieyu/DigitalAudioMixer/Parts/W25Q64JVSSIQ/SOIC-8_5P28X5P28_WIN.step

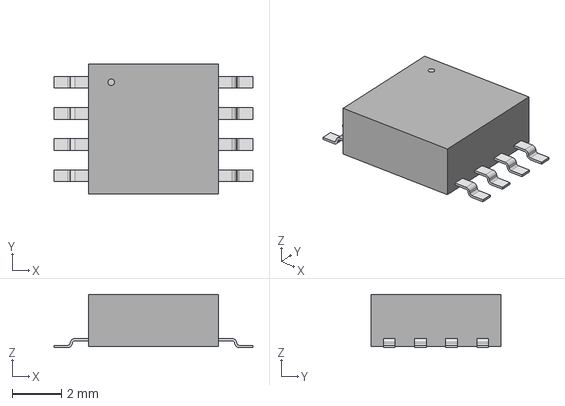
[picture p51: CAD file, 2024-09-13]
Parts/W25Q64JVSSIQ/SOIC-8_5P28X5P28_WIN.step
8.10 x 5.28 x 2.16 mm
