joshieyu/DigitalAudioMixer/Parts/XRCGB25M000F3A00R0/XRCGB25M000F3A00R0.step

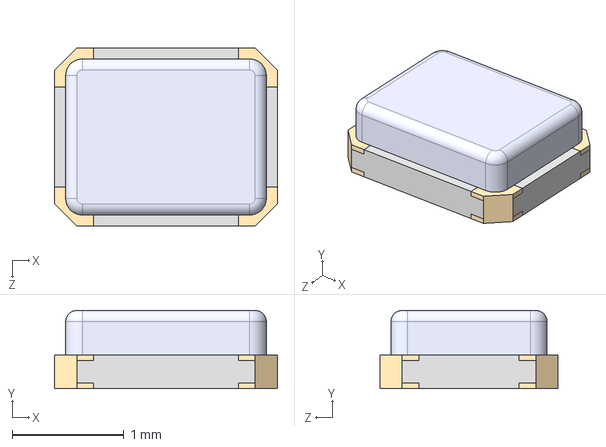
[picture p52: CAD file, 2024-11-21]
Parts/XRCGB25M000F3A00R0/XRCGB25M000F3A00R0.step
2.00 x 0.7 x 1.60 mm
