joshieyu/DigitalAudioMixer/CAD/Parts/rotary-encoder-1.snapshot.8/rotary encoder step files/Step Files/5 pin header.stp

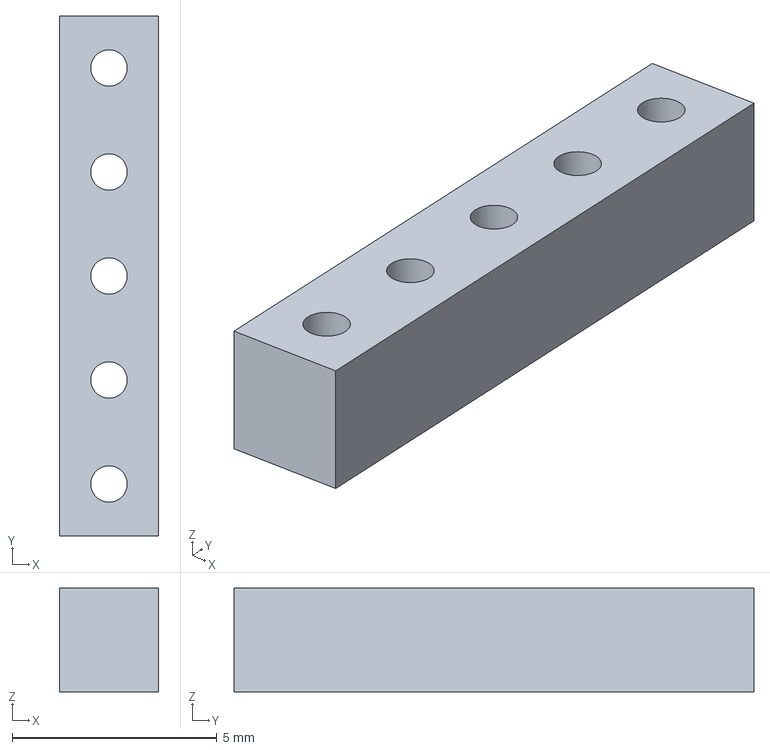
[picture p53: CAD file, 2024-07-25]
CAD/Parts/rotary-encoder-1.snapshot.8/rotary encoder step files/Step Files/5 pin header.stp
2.41 x 12.7 x 2.54 mm
