joshieyu/DigitalAudioMixer/CAD/Parts/rotary-encoder-1.snapshot.8/rotary encoder step files/Step Files/mtg flange.stp

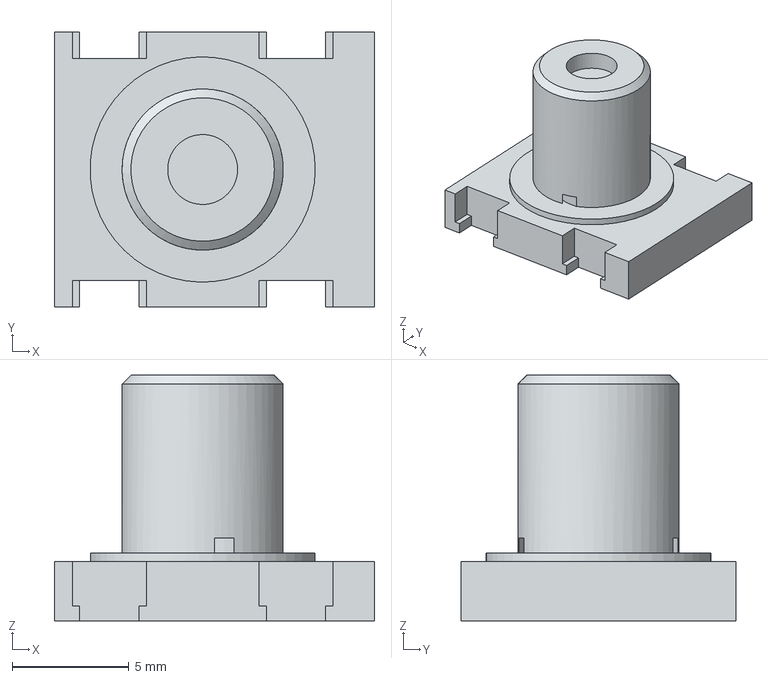
[picture p54: CAD file, 2024-07-25]
CAD/Parts/rotary-encoder-1.snapshot.8/rotary encoder step files/Step Files/mtg flange.stp
13.7 x 11.8 x 10.5 mm
