joshieyu/DigitalAudioMixer/CAD/Parts/rotary-encoder-1.snapshot.8/rotary encoder step files/Step Files/body_2.stp

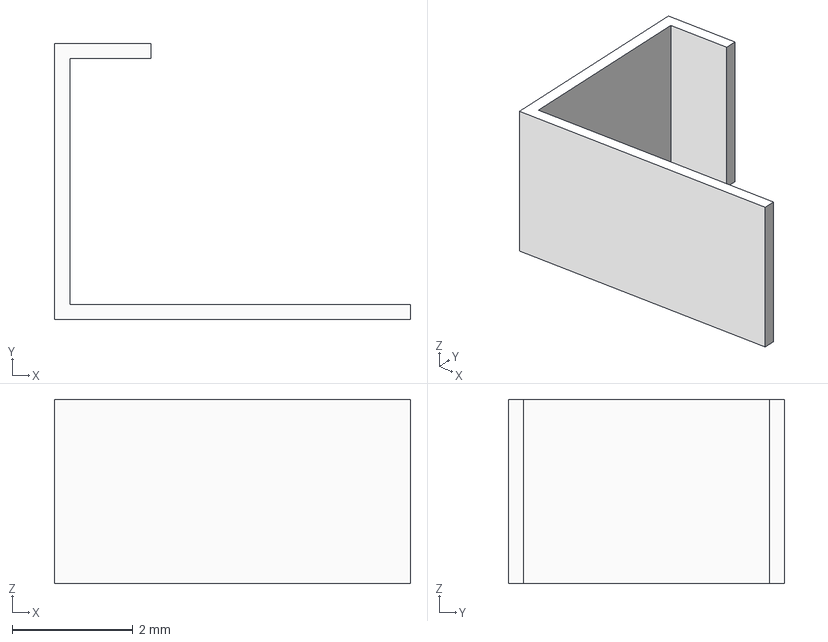
[picture p55: CAD file, 2024-07-25]
CAD/Parts/rotary-encoder-1.snapshot.8/rotary encoder step files/Step Files/body_2.stp
5.89 x 4.57 x 3.05 mm
