joshieyu/DigitalAudioMixer/CAD/Parts/rotary-encoder-1.snapshot.8/rotary encoder step files/Step Files/rotary encoder_chesr_2013.stp

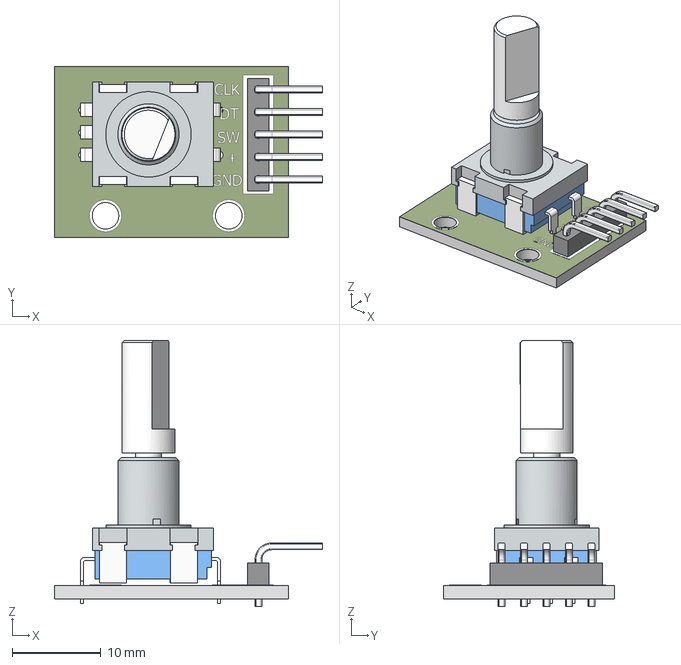
[picture p56: CAD file, 2024-07-25]
CAD/Parts/rotary-encoder-1.snapshot.8/rotary encoder step files/Step Files/rotary encoder_chesr_2013.stp
30.3 x 19.3 x 30.1 mm
