joshieyu/DigitalAudioMixer/CAD/Parts/rotary-encoder-1.snapshot.8/rotary encoder step files/Step Files/pins_encoder body_2.stp

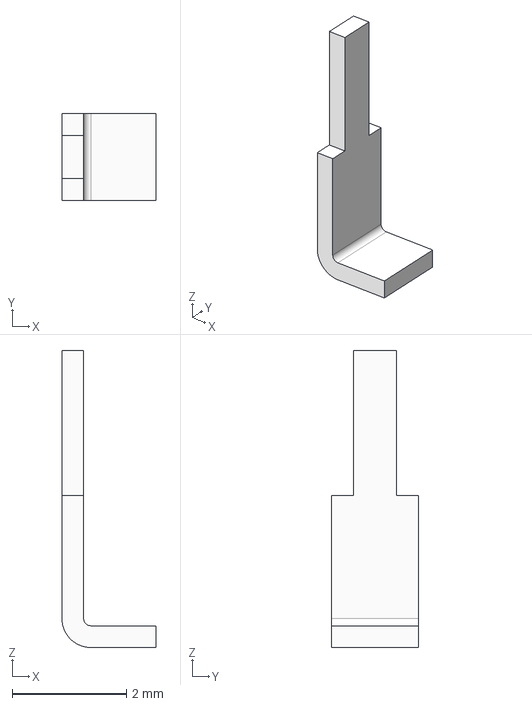
[picture p57: CAD file, 2024-07-25]
CAD/Parts/rotary-encoder-1.snapshot.8/rotary encoder step files/Step Files/pins_encoder body_2.stp
1.65 x 1.52 x 5.21 mm
