joshieyu/DigitalAudioMixer/(list of files, cad)

Other CAD files:
CAD/Parts/trs-jack-pj-313-1.snapshot.1/TRS Jack PJ-313.stp
CAD/Parts/trs-jack-pj-313-1.snapshot.1/TRS Jack PJ-313/3.sldprt
CAD/Parts/trs-jack-pj-313-1.snapshot.1/TRS Jack PJ-313/4.sldprt
CAD/Parts/trs-jack-pj-313-1.snapshot.1/TRS Jack PJ-313/2.sldprt
CAD/Parts/trs-jack-pj-313-1.snapshot.1/TRS Jack PJ-313/1.sldprt
CAD/Parts/ky-040-knob-1.snapshot.2/KY-040 Knob v2.SLDPRT
CAD/Parts/rotary-encoder-1.snapshot.8/Rotary Encoder/5 pin header.ipt
CAD/Parts/rotary-encoder-1.snapshot.8/Rotary Encoder/90d pin_header.ipt
CAD/Parts/rotary-encoder-1.snapshot.8/Rotary Encoder/OldVersions/mtg flange.0001.ipt
CAD/Parts/rotary-encoder-1.snapshot.8/Rotary Encoder/OldVersions/pins_encoder body_2.0001.ipt
CAD/Parts/rotary-encoder-1.snapshot.8/Rotary Encoder/OldVersions/pins_encoder body_2_2.0001.ipt
CAD/Parts/rotary-encoder-1.snapshot.8/Rotary Encoder/OldVersions/rotary encoder_chesr_2013.0010.iam
CAD/Parts/rotary-encoder-1.snapshot.8/Rotary Encoder/body_2.ipt
CAD/Parts/rotary-encoder-1.snapshot.8/Rotary Encoder/body_encoder.ipt
CAD/Parts/rotary-encoder-1.snapshot.8/Rotary Encoder/decal_encoder.ipt
CAD/Parts/rotary-encoder-1.snapshot.8/Rotary Encoder/mtg flange.ipt
CAD/Parts/rotary-encoder-1.snapshot.8/Rotary Encoder/pcb.ipt
CAD/Parts/rotary-encoder-1.snapshot.8/Rotary Encoder/pins_encoder body_2.ipt
CAD/Parts/rotary-encoder-1.snapshot.8/Rotary Encoder/pins_encoder body_2_2.ipt
CAD/Parts/rotary-encoder-1.snapshot.8/Rotary Encoder/rotary encoder_chesr_2013.iam
CAD/Parts/rotary-encoder-1.snapshot.8/Rotary Encoder/shaft_encoder.ipt
