joshieyu/DigitalAudioMixer/Documentation/Images/OPA2134Test.jpg

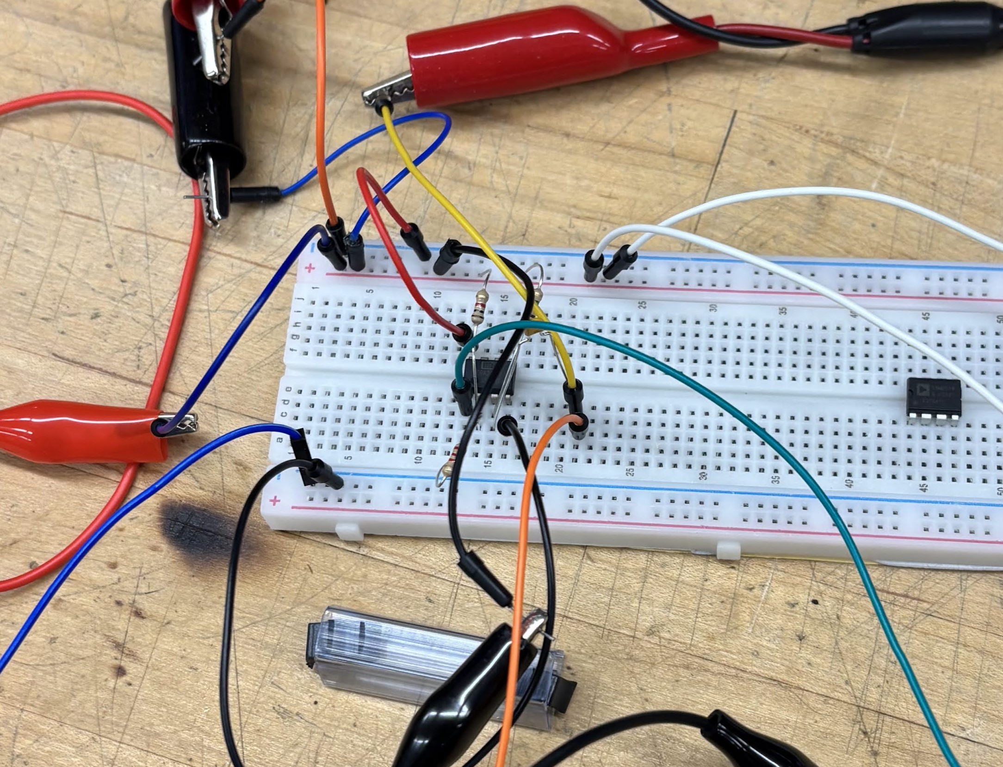
Documentation/Images/OPA2134Test.jpg
