joshieyu/DigitalAudioMixer/Documentation/Images/SSM2019Test.JPG

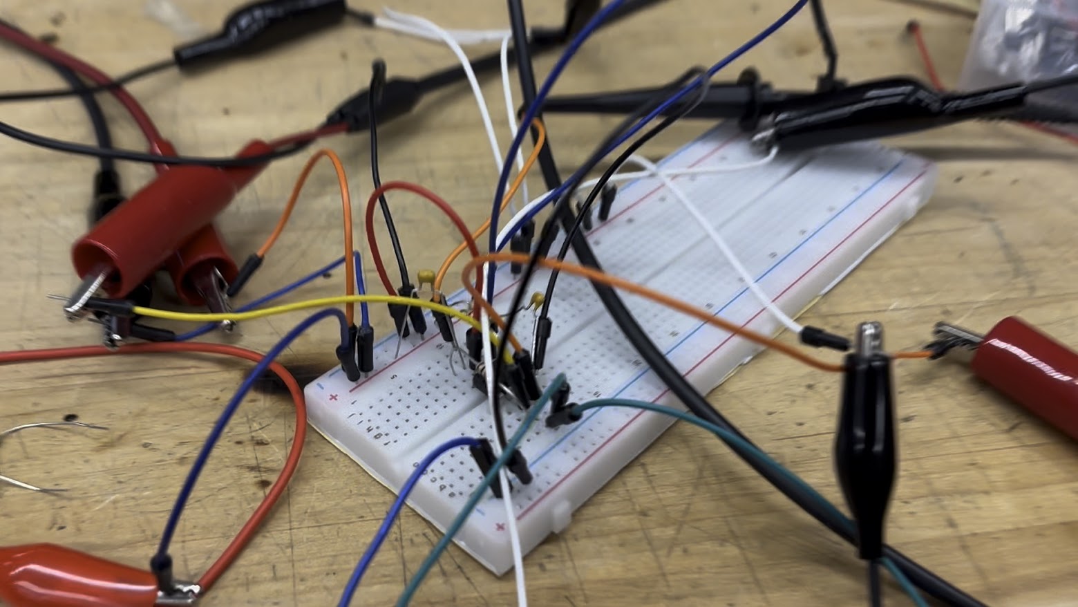
Documentation/Images/SSM2019Test.JPG
