joshieyu/DigitalAudioMixer/Resources/XK-AUDIO-316-MC-AB-Design-Files/XK-AUDIO-316-MC-AB-PCBA-1V1-A/XK-AUDIO-316-MC-AB-ASSY-DWG-1V1-A.PDF

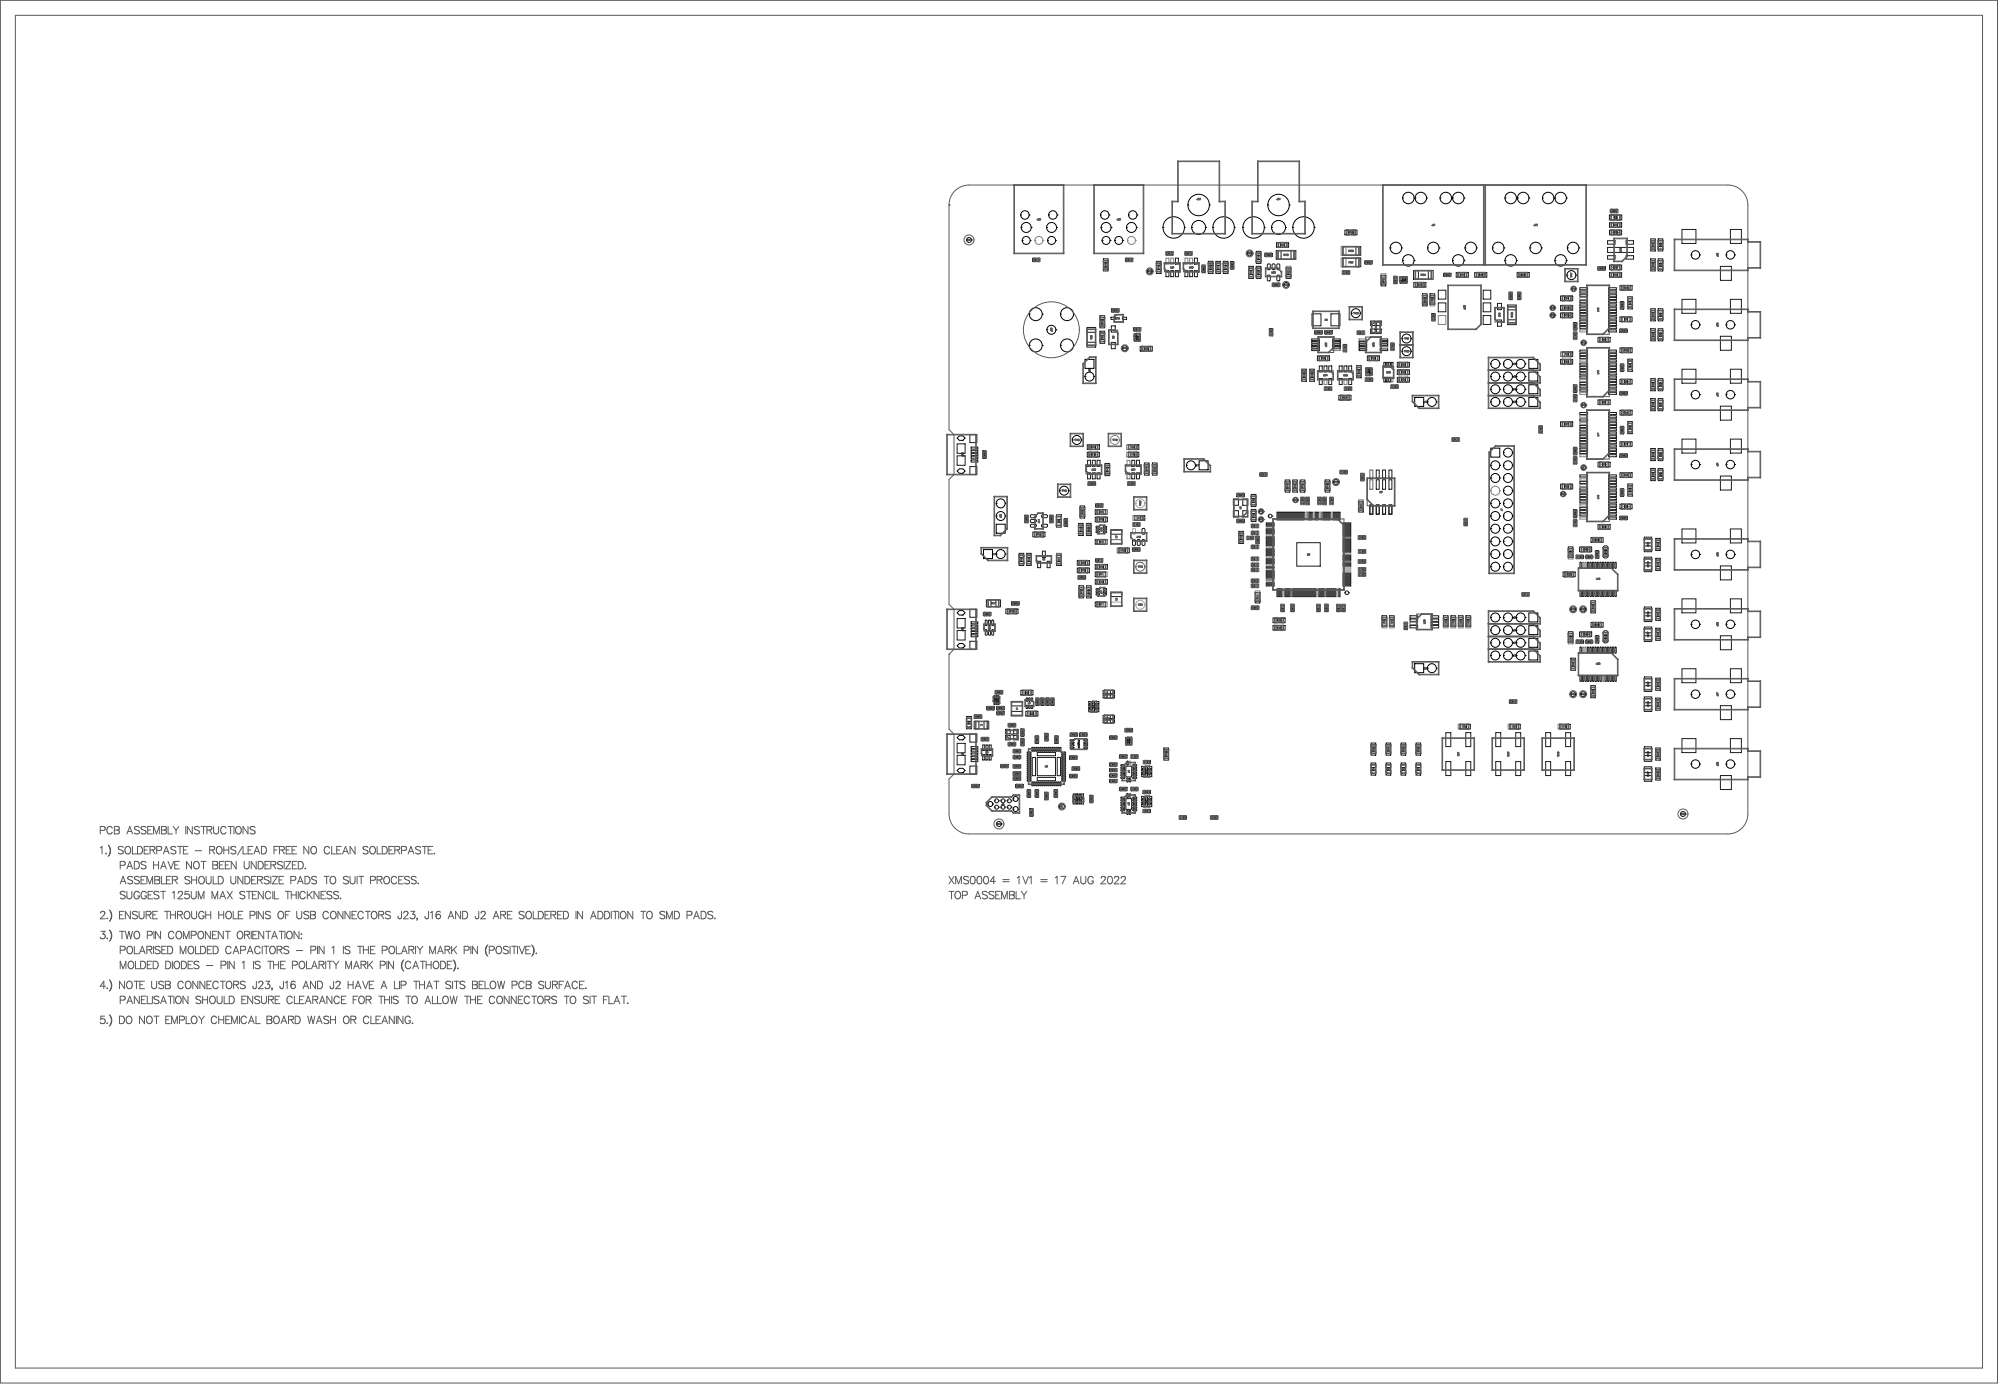
[picture p89: page 1]

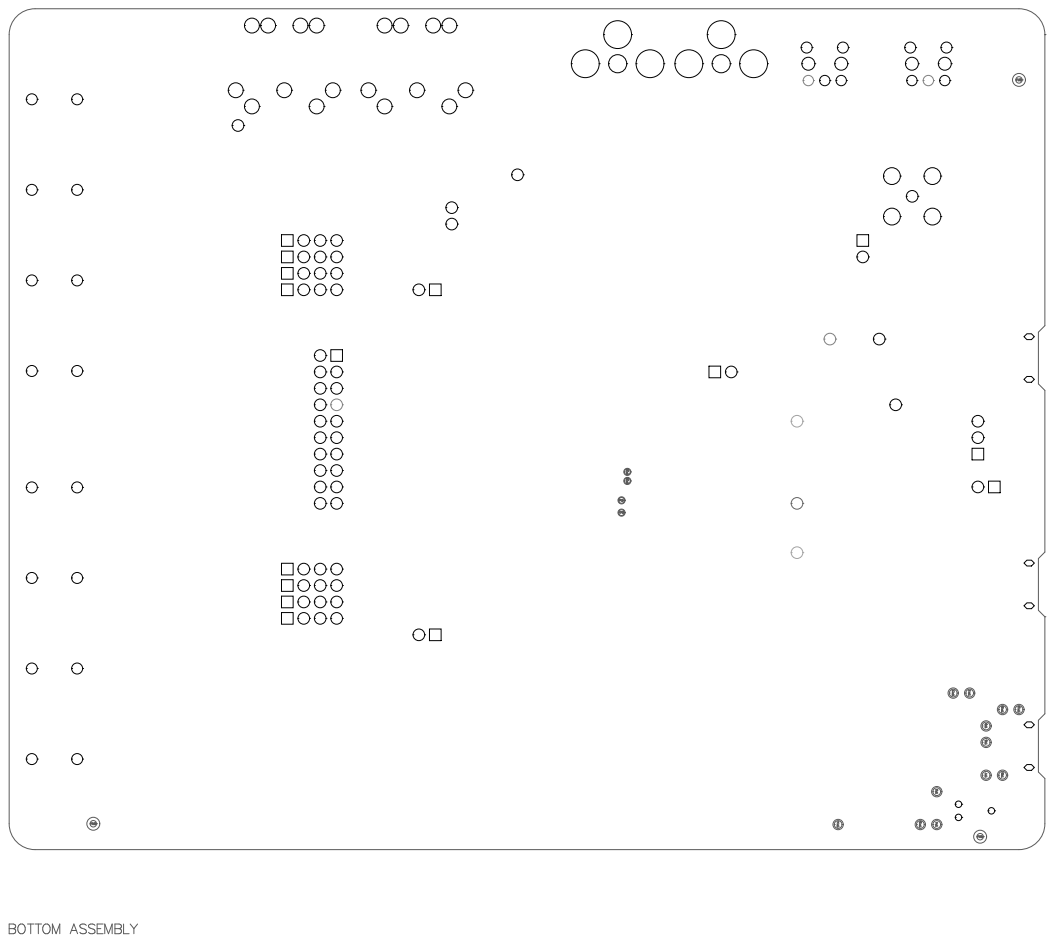
[picture p90: page 2]
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
