joshieyu/DigitalAudioMixer/(list of files, drawings)

Other design files:
Resources/XK-AUDIO-316-MC-AB-Design-Files/XK-AUDIO-316-MC-AB-1V1-ALTIUM/Schematic/ADC.SchDoc
Resources/XK-AUDIO-316-MC-AB-Design-Files/XK-AUDIO-316-MC-AB-1V1-ALTIUM/Schematic/Clocks.SchDoc
Resources/XK-AUDIO-316-MC-AB-Design-Files/XK-AUDIO-316-MC-AB-1V1-ALTIUM/Schematic/DAC.SchDoc
Resources/XK-AUDIO-316-MC-AB-Design-Files/XK-AUDIO-316-MC-AB-1V1-ALTIUM/Schematic/DigitalIO.SchDoc
Resources/XK-AUDIO-316-MC-AB-Design-Files/XK-AUDIO-316-MC-AB-1V1-ALTIUM/Schematic/Power.SchDoc
Resources/XK-AUDIO-316-MC-AB-Design-Files/XK-AUDIO-316-MC-AB-1V1-ALTIUM/Schematic/Top Level.SchDoc
Resources/XK-AUDIO-316-MC-AB-Design-Files/XK-AUDIO-316-MC-AB-1V1-ALTIUM/Schematic/XMOS.SchDoc
Resources/XK-AUDIO-316-MC-AB-Design-Files/XK-AUDIO-316-MC-AB-1V1-ALTIUM/Schematic/XTAG4.SchDoc
Resources/XK-AUDIO-316-MC-AB-Design-Files/XK-AUDIO-316-MC-AB-1V1-ALTIUM/XMS0004.PrjPcb
