joshieyu/DigitalAudioMixer/STMCube/STemWin/Core/Src/main.c

/**
  ******************************************************************************
  * @file    main.c 
  * @author  MCD Application Team
  * @brief   This file provides main program functions
  ******************************************************************************
  * @attention
  *
  * Copyright (c) 2016 STMicroelectronics.
  * All rights reserved.
  *
  * This software is licensed under terms that can be found in the LICENSE file
  * in the root directory of this software component.
  * If no LICENSE file comes with this software, it is provided AS-IS.
  *
  ******************************************************************************
  */

/* Includes ------------------------------------------------------------------*/
#include "main.h" 

/** @addtogroup CORE
  * @{
  */

/** @defgroup MAIN
* @brief main file
* @{
*/ 

/** @defgroup MAIN_Private_TypesDefinitions
* @{
*/ 
/**
* @}
*/ 

/** @defgroup MAIN_Private_Defines
* @{
*/ 
/**
* @}
*/ 


/** @defgroup MAIN_Private_Macros
* @{
*/ 
/**
* @}
*/ 


/** @defgroup MAIN_Private_Variables
* @{
*/
/**
* @}
*/ 


/** @defgroup MAIN_Private_FunctionPrototypes
* @{
*/ 
static void MPU_Config(void);
static void SystemClock_Config(void);
static void GUIThread(void const * argument);
static void TimerCallback(void const *n);

#if !defined ( __GNUC__ )
extern K_ModuleItem_Typedef  video_player_board;
#endif
extern K_ModuleItem_Typedef  audio_player_board;
extern K_ModuleItem_Typedef  games_board;
extern K_ModuleItem_Typedef  gardening_control_board;
extern K_ModuleItem_Typedef  home_alarm_board;
extern K_ModuleItem_Typedef  settings_board;
extern K_ModuleItem_Typedef  audio_recorder_board;
extern K_ModuleItem_Typedef  vnc_server;

osTimerId lcd_timer;

#if defined ( __ICCARM__ ) /*!< IAR Compiler */
#pragma location=0x20006024
uint8_t ucHeap[ configTOTAL_HEAP_SIZE ];
#elif defined ( __CC_ARM )
uint8_t ucHeap[ configTOTAL_HEAP_SIZE ] __attribute__((at(0x20006024)));
#elif defined ( __GNUC__ ) 
uint8_t ucHeap[ configTOTAL_HEAP_SIZE ] __attribute__((section(".RamData2")));
#endif

/**
* @}
*/ 

/** @defgroup MAIN_Private_Functions
* @{
*/ 

/**
* @brief  Main program
* @param  None
* @retval int
*/
int main(void)
{   
  /* Configure the MPU attributes */
  MPU_Config();

  /* Invalidate I-Cache : ICIALLU register */
  SCB_InvalidateICache();

  /* Enable branch prediction */
  SCB->CCR |= (1 <<18);
  __DSB();

  /* Invalidate I-Cache : ICIALLU register */
  SCB_InvalidateICache();

  /* Enable I-Cache */
  SCB_EnableICache();

  SCB_InvalidateDCache();
  SCB_EnableDCache();

  /* STM32F7xx HAL library initialization:
  - Configure the Flash ART accelerator on ITCM interface
  - Configure the Systick to generate an interrupt each 1 msec
  - Set NVIC Group Priority to 4
  - Global MSP (MCU Support Package) initialization
  */
  HAL_Init();
  
  /* Configure the system clock @ 200 Mhz */
  SystemClock_Config();
	
  /* Configure the board */
  k_BspInit(); 
  
  /* Initialize RTC */
  k_CalendarBkupInit();    
  
  /* Create GUI task */
  osThreadDef(GUI_Thread, GUIThread, osPriorityNormal, 0, 2 * 1024);
  osThreadCreate (osThread(GUI_Thread), NULL); 
  
  /* Add Modules*/
  k_ModuleInit();
  
  /* Link modules */ 
  k_ModuleAdd(&audio_player_board);
  #if !defined ( __GNUC__ )
  k_ModuleAdd(&video_player_board);
  #endif
  k_ModuleAdd(&audio_recorder_board);
  k_ModuleAdd(&vnc_server);
  k_ModuleAdd(&gardening_control_board); 
  k_ModuleAdd(&home_alarm_board); 
  k_ModuleAdd(&games_board);
  k_ModuleAdd(&settings_board);  

  /* Start scheduler */
  osKernelStart ();

  /* We should never get here as control is now taken by the scheduler */
  for( ;; );
}

/**
  * @brief  Start task
  * @param  argument: pointer that is passed to the thread function as start argument.
  * @retval None
  */
static void GUIThread(void const * argument)
{   
  /* Initialize Storage Units */
  k_StorageInit();

  /* Initialize GUI */
  GUI_Init();   

  WM_MULTIBUF_Enable(1);
  GUI_SetLayerVisEx (1, 0);
  GUI_SelectLayer(0);

  GUI_SetBkColor(GUI_WHITE);
  GUI_Clear();  

   /* Set General Graphical proprieties */
  k_SetGuiProfile();

  /* Demo Startup */
  k_StartUp();

  /* Create Touch screen Timer */
  osTimerDef(TS_Timer, TimerCallback);
  lcd_timer =  osTimerCreate(osTimer(TS_Timer), osTimerPeriodic, (void *)0);

  /* Start the TS Timer */
  osTimerStart(lcd_timer, 100);
  
  /* Show the main menu */
  k_InitMenu();
    
  /* Gui background Task */
  while(1) {
    GUI_Exec(); /* Do the background work ... Update windows etc.) */
    k_PeriodicProcesses();
    osDelay(20); /* Nothing left to do for the moment ... Idle processing */
  }
}

/**
  * @brief  Timer callback (40 ms)
  * @param  n: Timer index 
  * @retval None
  */
static void TimerCallback(void const *n)
{  
  k_TouchUpdate();
}

/**
  * @brief  System Clock Configuration
  *         The system Clock is configured as follow : 
  *            System Clock source            = PLL (HSE)
  *            SYSCLK(Hz)                     = 200000000
  *            HCLK(Hz)                       = 200000000
  *            AHB Prescaler                  = 1
  *            APB1 Prescaler                 = 4
  *            APB2 Prescaler                 = 2
  *            HSE Frequency(Hz)              = 25000000
  *            PLL_M                          = 25
  *            PLL_N                          = 400
  *            PLL_P                          = 2
  *            PLLSAI_N                       = 384
  *            PLLSAI_P                       = 8
  *            VDD(V)                         = 3.3
  *            Main regulator output voltage  = Scale1 mode
  *            Flash Latency(WS)              = 6
  * @param  None
  * @retval None
  */
void SystemClock_Config(void)
{
  RCC_ClkInitTypeDef RCC_ClkInitStruct;
  RCC_OscInitTypeDef RCC_OscInitStruct;
  HAL_StatusTypeDef ret = HAL_OK;

  /* Enable HSE Oscillator and activate PLL with HSE as source */
  RCC_OscInitStruct.OscillatorType = RCC_OSCILLATORTYPE_HSE;
  RCC_OscInitStruct.HSEState = RCC_HSE_ON;
  RCC_OscInitStruct.PLL.PLLState = RCC_PLL_ON;
  RCC_OscInitStruct.PLL.PLLSource = RCC_PLLSOURCE_HSE;
  RCC_OscInitStruct.PLL.PLLM = 25;
  RCC_OscInitStruct.PLL.PLLN = 400;
  RCC_OscInitStruct.PLL.PLLP = RCC_PLLP_DIV2;
  HAL_RCC_OscConfig(&RCC_OscInitStruct);
          
  ret = HAL_PWREx_EnableOverDrive();

  if(ret != HAL_OK)
  {
    while(1) { ; }
  }  
  
  /* Select PLL as system clock source and configure the HCLK, PCLK1 and PCLK2 
     clocks dividers */
  RCC_ClkInitStruct.ClockType = (RCC_CLOCKTYPE_SYSCLK | RCC_CLOCKTYPE_HCLK | RCC_CLOCKTYPE_PCLK1 | RCC_CLOCKTYPE_PCLK2);
  RCC_ClkInitStruct.SYSCLKSource = RCC_SYSCLKSOURCE_PLLCLK;
  RCC_ClkInitStruct.AHBCLKDivider = RCC_SYSCLK_DIV1;
  RCC_ClkInitStruct.APB1CLKDivider = RCC_HCLK_DIV4;
  RCC_ClkInitStruct.APB2CLKDivider = RCC_HCLK_DIV2;
  HAL_RCC_ClockConfig(&RCC_ClkInitStruct, FLASH_LATENCY_6);
}

/**
  * @brief  Configure the MPU attributes as Normal Non Cacheable for SRAM1/2.
  * @note   The Base Address is 0x20010000 since this memory interface is the AXI.
  *         The Region Size is 256KB, it is related to SRAM1 and SRAM2  memory size.
  * @param  None
  * @retval None
  */
static void MPU_Config(void)
{
  MPU_Region_InitTypeDef MPU_InitStruct;
  
  /* Disable the MPU */
  HAL_MPU_Disable();
  
  /* Configure the MPU as Strongly ordered for not defined regions */
  MPU_InitStruct.Enable = MPU_REGION_ENABLE;
  MPU_InitStruct.BaseAddress = 0x00;
  MPU_InitStruct.Size = MPU_REGION_SIZE_4GB;
  MPU_InitStruct.AccessPermission = MPU_REGION_NO_ACCESS;
  MPU_InitStruct.IsBufferable = MPU_ACCESS_NOT_BUFFERABLE;
  MPU_InitStruct.IsCacheable = MPU_ACCESS_NOT_CACHEABLE;
  MPU_InitStruct.IsShareable = MPU_ACCESS_SHAREABLE;
  MPU_InitStruct.Number = MPU_REGION_NUMBER0;
  MPU_InitStruct.TypeExtField = MPU_TEX_LEVEL0;
  MPU_InitStruct.SubRegionDisable = 0x87;
  MPU_InitStruct.DisableExec = MPU_INSTRUCTION_ACCESS_DISABLE;

  HAL_MPU_ConfigRegion(&MPU_InitStruct);
  
  /* Configure the MPU as Normal Non Cacheable for the SRAM1 and SRAM2 */
  MPU_InitStruct.Enable = MPU_REGION_ENABLE;
  MPU_InitStruct.BaseAddress = 0x20010000;
  MPU_InitStruct.Size = MPU_REGION_SIZE_256KB;
  MPU_InitStruct.AccessPermission = MPU_REGION_FULL_ACCESS;
  MPU_InitStruct.IsBufferable = MPU_ACCESS_NOT_BUFFERABLE;
  MPU_InitStruct.IsCacheable = MPU_ACCESS_NOT_CACHEABLE;
  MPU_InitStruct.IsShareable = MPU_ACCESS_SHAREABLE;
  MPU_InitStruct.Number = MPU_REGION_NUMBER1;
  MPU_InitStruct.TypeExtField = MPU_TEX_LEVEL1;
  MPU_InitStruct.SubRegionDisable = 0x00;
  MPU_InitStruct.DisableExec = MPU_INSTRUCTION_ACCESS_ENABLE;

  HAL_MPU_ConfigRegion(&MPU_InitStruct);

  /* Configure the MPU attributes as WT for SDRAM */
  MPU_InitStruct.Enable = MPU_REGION_ENABLE;
  MPU_InitStruct.BaseAddress = 0xC0000000;
  MPU_InitStruct.Size = MPU_REGION_SIZE_32MB;
  MPU_InitStruct.AccessPermission = MPU_REGION_FULL_ACCESS;
  MPU_InitStruct.IsBufferable = MPU_ACCESS_NOT_BUFFERABLE;
  MPU_InitStruct.IsCacheable = MPU_ACCESS_CACHEABLE;
  MPU_InitStruct.IsShareable = MPU_ACCESS_NOT_SHAREABLE;
  MPU_InitStruct.Number = MPU_REGION_NUMBER2;
  MPU_InitStruct.TypeExtField = MPU_TEX_LEVEL0;
  MPU_InitStruct.SubRegionDisable = 0x00;
  MPU_InitStruct.DisableExec = MPU_INSTRUCTION_ACCESS_ENABLE;

  HAL_MPU_ConfigRegion(&MPU_InitStruct);

  /* Configure the MPU QSPI flash */
  MPU_InitStruct.Enable = MPU_REGION_ENABLE;
  MPU_InitStruct.BaseAddress = 0x90000000;
  MPU_InitStruct.Size = MPU_REGION_SIZE_64MB;
  MPU_InitStruct.AccessPermission = MPU_REGION_FULL_ACCESS;
  MPU_InitStruct.IsBufferable = MPU_ACCESS_NOT_BUFFERABLE;
  MPU_InitStruct.IsCacheable = MPU_ACCESS_CACHEABLE;
  MPU_InitStruct.IsShareable = MPU_ACCESS_NOT_SHAREABLE;
  MPU_InitStruct.Number = MPU_REGION_NUMBER3;
  MPU_InitStruct.TypeExtField = MPU_TEX_LEVEL0;
  MPU_InitStruct.SubRegionDisable = 0x0;
  MPU_InitStruct.DisableExec = MPU_INSTRUCTION_ACCESS_ENABLE;


  HAL_MPU_ConfigRegion(&MPU_InitStruct);
  
  /* Configure the MPU attributes FMC control registers */
  MPU_InitStruct.Enable = MPU_REGION_ENABLE;
  MPU_InitStruct.BaseAddress = 0xA0000000;
  MPU_InitStruct.Size = MPU_REGION_SIZE_8KB;
  MPU_InitStruct.AccessPermission = MPU_REGION_FULL_ACCESS;
  MPU_InitStruct.IsBufferable = MPU_ACCESS_BUFFERABLE;
  MPU_InitStruct.IsCacheable = MPU_ACCESS_NOT_CACHEABLE;
  MPU_InitStruct.IsShareable = MPU_ACCESS_SHAREABLE;
  MPU_InitStruct.Number = MPU_REGION_NUMBER4;
  MPU_InitStruct.TypeExtField = MPU_TEX_LEVEL0;
  MPU_InitStruct.SubRegionDisable = 0x0;
  MPU_InitStruct.DisableExec = MPU_INSTRUCTION_ACCESS_DISABLE;
  
  HAL_MPU_ConfigRegion(&MPU_InitStruct);

  /* Enable the MPU */
  HAL_MPU_Enable(MPU_PRIVILEGED_DEFAULT);
}

#ifdef USE_FULL_ASSERT
/**
* @brief  assert_failed
*         Reports the name of the source file and the source line number
*         where the assert_param error has occurred.
* @param  File: pointer to the source file name
* @param  Line: assert_param error line source number
* @retval None
*/
void assert_failed(uint8_t* file, uint32_t line)
{
  /* User can add his own implementation to report the file name and line
  number,ex: printf("Wrong parameters value: file %s on line %d\r\n", 
  file, line) */
  
  /* Infinite loop */
  while (1)
  {}
}

#endif


/**
* @}
*/ 

/**
* @}
*/ 

/**
* @}
*/ 
