joshieyu/DigitalAudioMixer/STMCube/testProject/Core/Src/main.c

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
/* Includes ------------------------------------------------------------------*/
#include "main.h"
#include "string.h"
#include "cmsis_os.h"
#include "fatfs.h"
#include "usb_host.h"

/* USER CODE BEGIN PD */
#define BUFFER_SIZE 128
#define BUFFER_SIZE_IN_BYTES 256
/* USER CODE END PD */

/* USER CODE BEGIN PM */
#define INT16_TO_FLOAT 1.0f/(32768.0f)
#define FLOAT_TO_INT16 32768.0f
/* USER CODE END PM */

#if defined ( __ICCARM__ ) /*!< IAR Compiler */
#pragma location=0x2004c000
ETH_DMADescTypeDef  DMARxDscrTab[ETH_RX_DESC_CNT]; /* Ethernet Rx DMA Descriptors */
#pragma location=0x2004c0a0
ETH_DMADescTypeDef  DMATxDscrTab[ETH_TX_DESC_CNT]; /* Ethernet Tx DMA Descriptors */

#elif defined ( __CC_ARM )  /* MDK ARM Compiler */

__attribute__((at(0x2004c000))) ETH_DMADescTypeDef  DMARxDscrTab[ETH_RX_DESC_CNT]; /* Ethernet Rx DMA Descriptors */
__attribute__((at(0x2004c0a0))) ETH_DMADescTypeDef  DMATxDscrTab[ETH_TX_DESC_CNT]; /* Ethernet Tx DMA Descriptors */

#elif defined ( __GNUC__ ) /* GNU Compiler */

ETH_DMADescTypeDef DMARxDscrTab[ETH_RX_DESC_CNT] __attribute__((section(".RxDecripSection"))); /* Ethernet Rx DMA Descriptors */
ETH_DMADescTypeDef DMATxDscrTab[ETH_TX_DESC_CNT] __attribute__((section(".TxDecripSection")));   /* Ethernet Tx DMA Descriptors */
#endif

ETH_TxPacketConfig TxConfig;

ADC_HandleTypeDef hadc3;

CRC_HandleTypeDef hcrc;

DCMI_HandleTypeDef hdcmi;

DMA2D_HandleTypeDef hdma2d;

ETH_HandleTypeDef heth;

I2C_HandleTypeDef hi2c1;
I2C_HandleTypeDef hi2c3;

LTDC_HandleTypeDef hltdc;

QSPI_HandleTypeDef hqspi;

RTC_HandleTypeDef hrtc;

SAI_HandleTypeDef hsai_BlockA2;
SAI_HandleTypeDef hsai_BlockB2;
DMA_HandleTypeDef hdma_sai2_a;
DMA_HandleTypeDef hdma_sai2_b; // Maybe switch to a

SD_HandleTypeDef hsd1;

SPDIFRX_HandleTypeDef hspdif;

SPI_HandleTypeDef hspi2;

TIM_HandleTypeDef htim1;
TIM_HandleTypeDef htim2;
TIM_HandleTypeDef htim3;
TIM_HandleTypeDef htim5;
TIM_HandleTypeDef htim8;
TIM_HandleTypeDef htim12;

UART_HandleTypeDef huart1;
UART_HandleTypeDef huart6;

SDRAM_HandleTypeDef hsdram1;

osThreadId defaultTaskHandle;
/* USER CODE BEGIN PV */
int16_t adcData[BUFFER_SIZE];
int16_t dacData[BUFFER_SIZE];

static volatile int16_t *inBufPtr;
static volatile int16_t *outBufPtr = &dacData[0];

uint8_t dataReadyFlag = 0;
/* USER CODE END PV */

void SystemClock_Config(void);
void PeriphCommonClock_Config(void);
static void MX_GPIO_Init(void);
static void MX_DMA_Init(void);
static void MX_CRC_Init(void);
static void MX_DCMI_Init(void);
static void MX_DMA2D_Init(void);
static void MX_ETH_Init(void);
static void MX_FMC_Init(void);
static void MX_I2C1_Init(void);
static void MX_I2C3_Init(void);
static void MX_LTDC_Init(void);
static void MX_QUADSPI_Init(void);
static void MX_RTC_Init(void);
static void MX_SAI2_Init(void);
static void MX_SDMMC1_SD_Init(void);
static void MX_SPDIFRX_Init(void);
static void MX_SPI2_Init(void);
static void MX_TIM1_Init(void);
static void MX_TIM2_Init(void);
static void MX_TIM3_Init(void);
static void MX_TIM5_Init(void);
static void MX_TIM8_Init(void);
static void MX_TIM12_Init(void);
static void MX_USART1_UART_Init(void);
static void MX_USART6_UART_Init(void);
static void MX_ADC3_Init(void);
void StartDefaultTask(void const * argument);

/* USER CODE BEGIN 0 */
void HAL_SAI_RxHalfCpltCallback(SAI_HandleTypeDef *hsai) {
	inBufPtr = &adcData[0];
	outBufPtr = &dacData[0];

	dataReadyFlag = 1;
}

void HAL_SAI_RxCpltCallback(SAI_HandleTypeDef *hsai) {
	inBufPtr = &adcData[BUFFER_SIZE/2];
	outBufPtr = &dacData[BUFFER_SIZE/2];

	dataReadyFlag = 1;
}

void processData() {

	static float leftIn, leftOut;
	static float rightIn, rightOut;

	for (uint8_t n = 0; n < (BUFFER_SIZE/2) - 1; n += 2) {

		// Left Channel

		// Get ADC input, convert to float
		leftIn = INT16_TO_FLOAT * inBufPtr[n];
		if (leftIn > 1.0f) {
			leftIn -= 2.0f;
		}

		leftOut = leftIn;

		// Convert back to signed int and set DAC output
		outBufPtr[n] = (int16_t) (FLOAT_TO_INT16 * leftOut);

		// Right Channel

		// Get ADC input, convert to float
		rightIn = INT16_TO_FLOAT * inBufPtr[n + 1];
		if (rightIn > 1.0f) {
			rightIn -= 2.0f;
		}

		rightOut = rightIn;

		// convert back to signed int and set DAC output
		outBufPtr[n + 1] = (int16_t) (FLOAT_TO_INT16 * rightOut);
	}

	dataReadyFlag = 0;
}
/* USER CODE END 0 */

/**
  * @brief  The application entry point.
  * @retval int
  */
int main(void)
{

  /* MCU Configuration--------------------------------------------------------*/

  /* Reset of all peripherals, Initializes the Flash interface and the Systick. */
  HAL_Init();

  /* Configure the system clock */
  SystemClock_Config();

/* Configure the peripherals common clocks */
  PeriphCommonClock_Config();

  /* Initialize all configured peripherals */
  MX_GPIO_Init();
  MX_DMA_Init();
  MX_CRC_Init();
  MX_DCMI_Init();
  MX_DMA2D_Init();
  MX_ETH_Init();
  MX_FMC_Init();
  MX_I2C1_Init();
  MX_I2C3_Init();
  MX_LTDC_Init();
  MX_QUADSPI_Init();
  MX_RTC_Init();
  MX_SAI2_Init();
  MX_SDMMC1_SD_Init();
  MX_SPDIFRX_Init();
  MX_SPI2_Init();
  MX_TIM1_Init();
  MX_TIM2_Init();
  MX_TIM3_Init();
  MX_TIM5_Init();
  MX_TIM8_Init();
  MX_TIM12_Init();
  MX_USART1_UART_Init();
  MX_USART6_UART_Init();
  MX_FATFS_Init();
  MX_ADC3_Init();
  /* USER CODE BEGIN 2 */
  HAL_StatusTypeDef transmitStatus = HAL_SAI_Transmit_DMA(&hsai_BlockB2, (uint8_t *)dacData, BUFFER_SIZE_IN_BYTES);
  HAL_StatusTypeDef receiveStatus = HAL_SAI_Receive_DMA(&hsai_BlockB2, (uint8_t *)adcData, BUFFER_SIZE_IN_BYTES);
  /* USER CODE END 2 */

  /* USER CODE BEGIN RTOS_MUTEX */
  /* add mutexes, ... */
  /* USER CODE END RTOS_MUTEX */

  /* USER CODE BEGIN RTOS_SEMAPHORES */
  /* add semaphores, ... */
  /* USER CODE END RTOS_SEMAPHORES */

  /* USER CODE BEGIN RTOS_TIMERS */
  /* start timers, add new ones, ... */
  /* USER CODE END RTOS_TIMERS */

  /* USER CODE BEGIN RTOS_QUEUES */
  /* add queues, ... */
  /* USER CODE END RTOS_QUEUES */

  /* Create the thread(s) */
  /* definition and creation of defaultTask */
  osThreadDef(defaultTask, StartDefaultTask, osPriorityNormal, 0, 4096);
  defaultTaskHandle = osThreadCreate(osThread(defaultTask), NULL);

  /* USER CODE BEGIN RTOS_THREADS */
  /* add threads, ... */
  /* USER CODE END RTOS_THREADS */

  /* Start scheduler */
  osKernelStart();

  /* We should never get here as control is now taken by the scheduler */

  /* Infinite loop */
  /* USER CODE BEGIN WHILE */
  while (1)
  {
    /* USER CODE END WHILE */
	  if (dataReadyFlag) {
		  processData();
	  }
    /* USER CODE BEGIN 3 */
  }
  /* USER CODE END 3 */
}

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
/* USER CODE BEGIN Header_StartDefaultTask */
/**
  * @brief  Function implementing the defaultTask thread.
  * @param  argument: Not used
  * @retval None
  */
/* USER CODE END Header_StartDefaultTask */
void StartDefaultTask(void const * argument)
{
  /* init code for USB_HOST */
  MX_USB_HOST_Init();
  /* USER CODE BEGIN 5 */
  /* Infinite loop */
  for(;;)
  {
    osDelay(1);
  }
  /* USER CODE END 5 */
}

/**
  * @brief  Period elapsed callback in non blocking mode
  * @note   This function is called  when TIM6 interrupt took place, inside
  * HAL_TIM_IRQHandler(). It makes a direct call to HAL_IncTick() to increment
  * a global variable "uwTick" used as application time base.
  * @param  htim : TIM handle
  * @retval None
  */
void HAL_TIM_PeriodElapsedCallback(TIM_HandleTypeDef *htim)
{
  if (htim->Instance == TIM6) {
    HAL_IncTick();
  }
}

/**
  * @brief  This function is executed in case of error occurrence.
  * @retval None
  */
void Error_Handler(void)
{
  /* USER CODE BEGIN Error_Handler_Debug */
  /* User can add his own implementation to report the HAL error return state */
  __disable_irq();
  while (1)
  {
  }
  /* USER CODE END Error_Handler_Debug */
}

#ifdef  USE_FULL_ASSERT
/**
  * @brief  Reports the name of the source file and the source line number
  *         where the assert_param error has occurred.
  * @param  file: pointer to the source file name
  * @param  line: assert_param error line source number
  * @retval None
  */
void assert_failed(uint8_t *file, uint32_t line)
{
  /* USER CODE BEGIN 6 */
  /* User can add his own implementation to report the file name and line number,
     ex: printf("Wrong parameters value: file %s on line %d\r\n", file, line) */
  /* USER CODE END 6 */
}
#endif /* USE_FULL_ASSERT */
