joshieyu/DigitalAudioMixer/(commit log)

2024-07-25 Added some files
    [1.sldprt, 2.sldprt, 3.sldprt, 4.sldprt, 5 pin header.ipt, 5 pin header.stp, 90d pin_header.ipt, 90d pin_header.stp]
2024-09-03 Added some PDFs
    [devBoardProject.kicad_pcb, devBoardProject.kicad_sch]
2024-09-03 Power Supply Circuitry
    [1.8V_PSU_sch.kicad_sch, 3.3V_PSU_sch.kicad_sch, 5V_PSU_sch.kicad_sch, Power_Supplies.kicad_pcb, Power_Supplies.kicad_sch]
2024-09-03 Uploaded new PDFs and design files
    [ADC.SchDoc, Clocks.SchDoc, DAC.SchDoc, DigitalIO.SchDoc, Power.SchDoc, Top Level.SchDoc, XK-AUDIO-316-MC-AB-BOM-1V1-A.xls, XK-AUDIO-316-MC-AB-XY-1V1-A.xls]
2024-09-06 Images + small kicad changes
2024-09-08 Updated power supplies and added DAC circuitry
    [1V_PSU_sch.kicad_sch, 3.3V_PSU_sch.kicad_sch, 5V_PSU_sch.kicad_sch, ADC.kicad_sch, DAC.kicad_sch, Power_Supplies.kicad_sch, untitled.kicad_sch]
2024-09-09 testing
    test
    [untitled.kicad_sch]
2024-09-09 Added ADC schematic
    yes
    [1V_PSU_sch.kicad_sch, ADC.kicad_sch, DAC.kicad_sch, freerouting.dsn, temp-freerouting.dsn, untitled.kicad_sch]
2024-09-10 Added xcore MCU, flash memory, main crystal clock
    [FA-238_EPS.step, Power_Supplies.kicad_sch, SOIC-8_5P28X5P28_WIN.step, XCORE.kicad_sch]
2024-09-23 Added Phantom Power, updated Xcore library things
    [ADC.kicad_sch, DAC.kicad_sch, Phantom.kicad_sch, Power_Supplies.kicad_pcb, Power_Supplies.kicad_sch, XCORE.kicad_sch, untitled.kicad_sch]
2024-09-30 Started preamp design (finished stage 1)
    [PREAMPS.kicad_sch, Phantom.kicad_sch, Power_Supplies.kicad_sch, XCORE.kicad_sch]
2024-10-03 Working on preamp
    [1.8V_PSU_sch.kicad_sch, 1V_PSU_sch.kicad_sch, 3.3V_PSU_sch.kicad_sch, 5V_PSU_sch.kicad_sch, ADC.kicad_sch, DAC.kicad_sch, PREAMPS.kicad_sch, Phantom.kicad_sch]
2024-10-11 Preamp draft 1
    [XCORE.kicad_sch]
2024-10-29 New preamp design + some added files
    [PREAMPS.kicad_sch, untitled.kicad_sch]
2024-10-29 Finished HiZ Inputs
    [1.8V_PSU_sch.kicad_sch, 1V_PSU_sch.kicad_sch, 3.3V_PSU_sch.kicad_sch, 5V_PSU_sch.kicad_sch, ADC.kicad_sch, DAC.kicad_sch, PREAMPS.kicad_sch, Phantom.kicad_sch]
2024-10-30 Updated circuits, added some schematic pictures
    Mostly just pushing so I can work on a different computer lol
    [PREAMPS.kicad_sch]
2024-11-01 Working on MCU IO
    [CON20_2X10_DUK_FTSH_SAI.step, PREAMPS.kicad_sch]
2024-11-01 Added 3.3V/1.8V LDO, clock IC
    [1.8V_PSU_sch.kicad_sch, 1V_PSU_sch.kicad_sch, 3.3V_PSU_sch.kicad_sch, 5V_PSU_sch.kicad_sch, ADC.kicad_sch, DAC.kicad_sch, PREAMPS.kicad_sch, Phantom.kicad_sch]
2024-11-05 big things are coming...
    [1.8V_PSU_sch.kicad_sch, 1V_PSU_sch.kicad_sch, 3.3V_PSU_sch.kicad_sch, 5V_PSU_sch.kicad_sch, ADC.kicad_sch, DAC.kicad_sch, PREAMPS.kicad_sch, Phantom.kicad_sch]
2024-11-05 More XCORE PCB updates
    Finished XTAG header, reinstated clock, worked on power pins
    [ADC.kicad_sch, XCORE.kicad_sch]
2024-11-08 added both ADCs, added differential output to DACs
    [ADC.kicad_sch, DAC.kicad_sch, PREAMPS.kicad_sch, Phantom.kicad_sch]
2024-11-12 More PCB work
    [BLM18AG601SZ1D.step, DAC.kicad_sch, XCORE.kicad_sch]
2024-11-13 Added BIG KNOB schematic and started PCB
    [Phantom.kicad_sch, Power_Supplies.kicad_pcb, freerouting.dsn]
2024-11-15 initial placement of all cmponents
    need to add:
    - pin headers for Rpi
    - separate the boards and add pin headers for connection points
    - probably get rid of buck converters and change LDOs to be higher current
    [DAC.kicad_sch, Phantom.kicad_sch, Power_Supplies.kicad_pcb, XCORE.kicad_sch]
2024-11-20 added power supply pcb (in power supply copy)
    [1.8V_PSU_sch.kicad_sch, 1V_PSU_sch.kicad_sch, 3.3V_PSU_sch.kicad_sch, 5V_PSU_sch.kicad_sch, ADC.kicad_sch, DAC.kicad_sch, PREAMPS.kicad_sch, Phantom.kicad_sch]
2024-11-20 Added stuff for the power supply circuitry
    changed all grounds to GND (same ground plane)
    [1.8V_PSU_sch.kicad_sch, 1V_PSU_sch.kicad_sch, 3.3V_PSU_sch.kicad_sch, 5V_PSU_sch.kicad_sch, ADC.kicad_sch, DAC.kicad_sch, PREAMPS.kicad_sch, Phantom.kicad_sch]
2024-11-20 Add files via upload
    fixed voltage issues
    [ADC.kicad_sch, DAC.kicad_sch, PREAMPS.kicad_sch, XCORE.kicad_sch]
2024-11-21 connected ADC/DACs, USB
    [ADC.kicad_sch, DAC.kicad_sch, PREAMPS.kicad_sch, XCORE.kicad_sch, XRCGB25M000F3A00R0.step]
2025-01-14 Init xcore usb audio sw
    [mic_array_das_beamformer_calcs.xls]
2025-01-21 Daughterboard PCB
    [1.8V_PSU_sch.kicad_sch, 1V_PSU_sch.kicad_sch, 3.3V_PSU_sch.kicad_sch, 5V_PSU_sch.kicad_sch, ADC.kicad_sch, DAC.kicad_sch, PREAMPS.kicad_sch, Phantom.kicad_sch]
2025-01-21 main PCB board (new, sorry)
    [1.8V_PSU_sch.kicad_sch, 1V_PSU_sch.kicad_sch, 3.3V_PSU_sch.kicad_sch, 5V_PSU_sch.kicad_sch, ADC.kicad_sch, DAC.kicad_sch, PREAMPS.kicad_sch, Phantom.kicad_sch]
2025-01-21 PCB for Power SUpply board :)
    [1.8V_PSU_sch.kicad_sch, 1V_PSU_sch.kicad_sch, 3.3V_PSU_sch.kicad_sch, 5V_PSU_sch.kicad_sch, ADC.kicad_sch, DAC.kicad_sch, PREAMPS.kicad_sch, Phantom.kicad_sch]
2025-01-24 1/3 of pcb
    [1.8V_PSU_sch.kicad_sch, 1V_PSU_sch.kicad_sch, 3.3V_PSU_sch.kicad_sch, 5V_PSU_sch.kicad_sch, ADC.kicad_sch, DAC.kicad_sch, PREAMPS.kicad_sch, Phantom.kicad_sch]
2025-01-24 2/3 of pcb
    [1.8V_PSU_sch.kicad_sch, 1V_PSU_sch.kicad_sch, 3.3V_PSU_sch.kicad_sch, 5V_PSU_sch.kicad_sch, ADC.kicad_sch, DAC.kicad_sch, PREAMPS.kicad_sch, Phantom.kicad_sch]
2025-01-24 3/3 of pain and suffering
    [1.8V_PSU_sch.kicad_sch, 1V_PSU_sch.kicad_sch, 3.3V_PSU_sch.kicad_sch, 5V_PSU_sch.kicad_sch, ADC.kicad_sch, DAC.kicad_sch, PREAMPS.kicad_sch, Phantom.kicad_sch]
2025-01-26 STM32 schematic started
    [Power_Supplies_DSP.kicad_sch, stm32.kicad_sch]
2025-01-26 STM32 schematic no HS USB
    [stm32.kicad_sch]
2025-01-27 mcu PCB
    [Power_Supplies_DSP.kicad_pcb, XCORE.kicad_sch, stm32.kicad_sch]
2025-01-27 updated main PCB to reflect changes w/ new mcu
    [ADC.kicad_sch, DAC.kicad_sch, Phantom.kicad_sch, Power_Supplies.kicad_pcb]
2025-01-28 added USB + fixed one routing on original DSP board
    [1.8V_PSU_sch.kicad_sch, 1V_PSU_sch.kicad_sch, 3.3V_PSU_sch.kicad_sch, 5V_PSU_sch.kicad_sch, ADC.kicad_sch, DAC.kicad_sch, PREAMPS.kicad_sch, Phantom.kicad_sch]
2025-01-28 fixed pcb conexions
    [Power_Supplies_DSP.kicad_pcb, stm32.kicad_sch]
2025-01-29 added changes that weeks wanted 🐷
    [ADC.kicad_sch, Phantom.kicad_sch, Power_Supplies.kicad_pcb, Power_Supplies_Copy.kicad_pcb, Power_Supplies_DSP.kicad_pcb, stm32.kicad_sch]
2025-01-29 fixed issue w mcu getting analog voltage supply (will just use digital)
    [Phantom.kicad_sch, Power_Supplies.kicad_pcb]
2025-01-29 fixed an oopsie w/ 3.3V on mcu board
    [Power_Supplies_DSP.kicad_pcb, stm32.kicad_sch]
2025-01-31 stuff i may or may not have done to order these things
    [PREAMPS.kicad_sch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]
2025-03-13 fixed a lot of stuff
    [ADC.kicad_sch, DAC.kicad_sch, PREAMPS.kicad_sch, Phantom.kicad_sch, Power_Supplies.kicad_pcb, Power_Supplies_DSP.kicad_pcb, stm32.kicad_sch]
2025-03-13 fixed power board problems/...
    [1.8V_PSU_sch.kicad_sch, PREAMPS.kicad_sch, Phantom.kicad_sch, Power_Supplies.kicad_pcb, Power_Supplies_Copy.kicad_pcb]
2025-03-15 created two new boards
    [1.8V_PSU_sch.kicad_sch, 1V_PSU_sch.kicad_sch, 3.3V_PSU_sch.kicad_sch, 5V_PSU_sch.kicad_sch, ADC.kicad_sch, Audio_Board_AD_Breakout.kicad_pcb, Audio_Board_AD_Breakout.kicad_sch, Audio_Board_Analog_Only.kicad_pcb]
2025-03-16 made new pcbs :(
    [Audio_Board_AD_Breakout.kicad_pcb, Audio_Board_Analog_Only.kicad_pcb, LDO.kicad_sch, PREAMPS.kicad_sch, Phantom.kicad_sch, Power_Supplies.kicad_pcb, Power_Supplies_Copy.kicad_pcb, bom.csv]
2025-04-04 aaaah (cooked)
    [1.8V_PSU_sch.kicad_sch, Audio_Board_AD_Breakout.kicad_pcb, Audio_Board_Analog_Only.kicad_pcb, Phantom.kicad_sch, Power_Supplies_Copy.kicad_pcb, bom.csv, bom2.csv, designators.csv]
