joshieyu/DigitalAudioMixer/(notices)

Notices in the files:
STMCube/testProject/Core/Src/main.c:
Copyright (c) 2024 STMicroelectronics.
All rights reserved.
